tamarkreit/Custom_STIC_RK3588/Datasheets and References/TPS22811_Design_Calculator.xlsm

Sheet: Calculation Sheet
TPS22811 Design Calculation Tool
 | Constants Cells
 | Input/SelectCells
 | Calculation Cells
 | Calculated, but can be over-ridden by user
 | Error Cells, Must be Fixed
Parameter | Description | Value | Units | Tolerance | Recommended Value
VIN (max) | Maximum Operating input voltage (magnitude) | 12.00 | V
OVLO Set Point | Desired Over Voltage Lockout Set Point | 15.00 | V | 3.0%
UVLO Set Point | Desired Undervoltage Threshold (VIN Rising) | 10.80 | V | 3.0%
VUVP | Internal Undervoltage Protection Threshold (VIN Rising) | 2.53 | V | 3.0%
Cout | Load Capacitance | 100.0 | uF | 10.0%
 | Is there downstream load present other than cap at startup? | YES
VONTH (CR) (V) | constant resistance load turn on threshold voltage | 0.0 | V
RLOAD (STARTUP) (Ω) | CR load at startup | 1.5 | Ohm
VONTH (CC) (V) | constant current load turn on threshold voltage | 1.0 | V
ILOAD (STARTUP) (A) | CC load at startup | 0.0 | A
VONTH (CP) (V) | constant power load turn on threshold voltage | 1.0 | V
PLOAD (STARTUP) (W) | CP load at startup | 0.0 | W
Istartup(A) | It is sum of max downstream load current and load cap charge current during startup .It should be <Imax | 8.22 | A
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
