tamarkreit/Custom_STIC_RK3588/v7_Power_Test_PCB/Symbols_and_Footprints/SN74LVC1G14DBVR/SN74LVC1G14DBVR.step

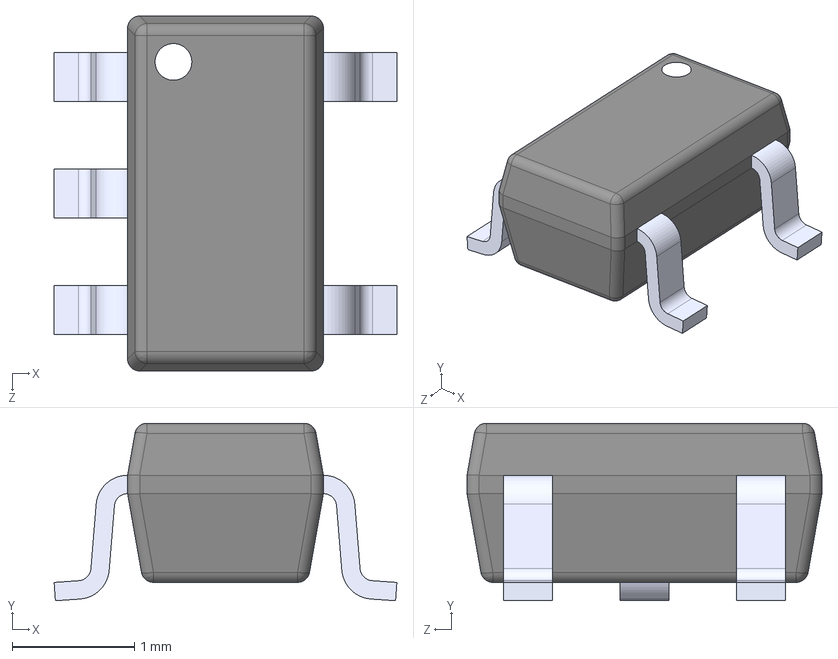
[picture p1: CAD file, 2025-10-29]
v7_Power_Test_PCB/Symbols_and_Footprints/SN74LVC1G14DBVR/SN74LVC1G14DBVR.step
2.80 x 1.45 x 2.90 mm
