tamarkreit/Custom_STIC_RK3588/v7_Power_Test_PCB/Symbols_and_Footprints/Sona_IF573/Sona_IF573_PCB_footprint/Sona IF573_PCB_Footprint.DXF

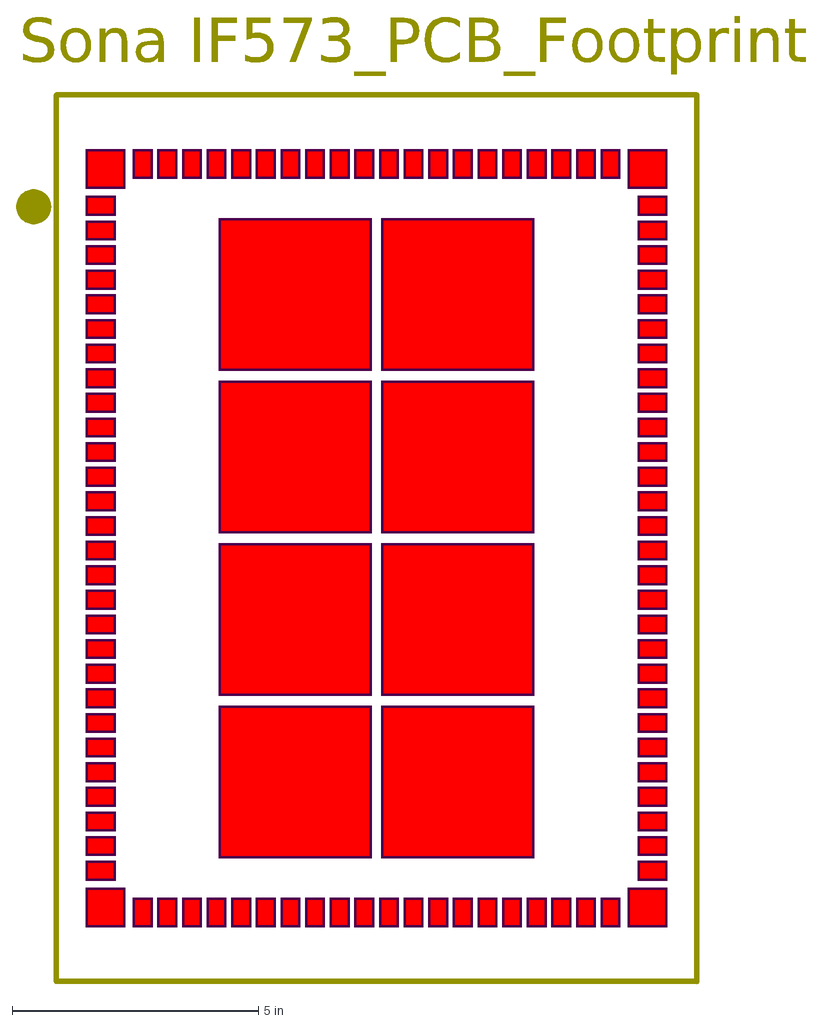
[picture p2: CAD file, 2025-10-29]
v7_Power_Test_PCB/Symbols_and_Footprints/Sona_IF573/Sona_IF573_PCB_footprint/Sona IF573_PCB_Footprint.DXF
Sona IF573_PCB_Footprint
