tamarkreit/Custom_STIC_RK3588/v7_Power_Test_PCB/Symbols_and_Footprints/TUSB320IRWBR/TUSB320IRWBR.step

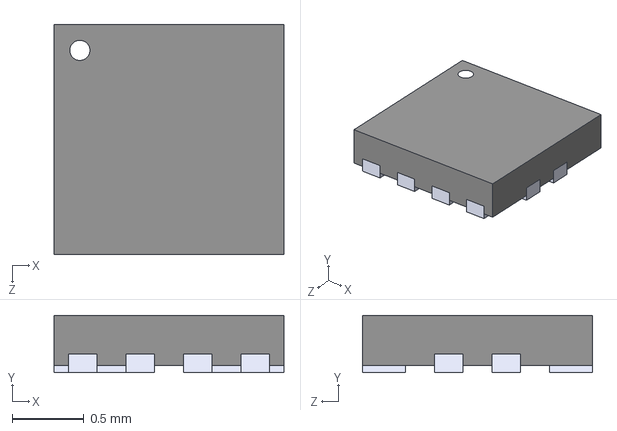
[picture p3: CAD file, 2025-10-16]
v7_Power_Test_PCB/Symbols_and_Footprints/TUSB320IRWBR/TUSB320IRWBR.step
1.60 x 0.4 x 1.60 mm
