tamarkreit/Custom_STIC_RK3588/v7_Power_Test_PCB/Symbols_and_Footprints/USB4056_03_A/USB4056-03-A_REVA2.step

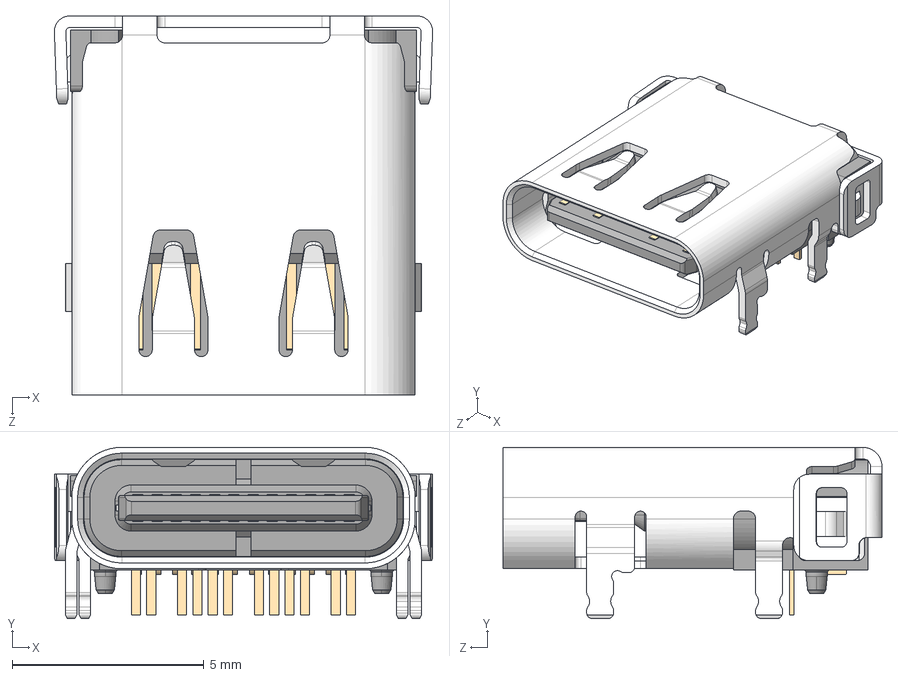
[picture p4: CAD file, 2025-10-16]
v7_Power_Test_PCB/Symbols_and_Footprints/USB4056_03_A/USB4056-03-A_REVA2.step
9.85 x 4.46 x 9.87 mm
