tamarkreit/Custom_STIC_RK3588/v7_Power_Test_PCB/Symbols_and_Footprints/USB4085_GF_A/USB4085-GF-A_REVB.step

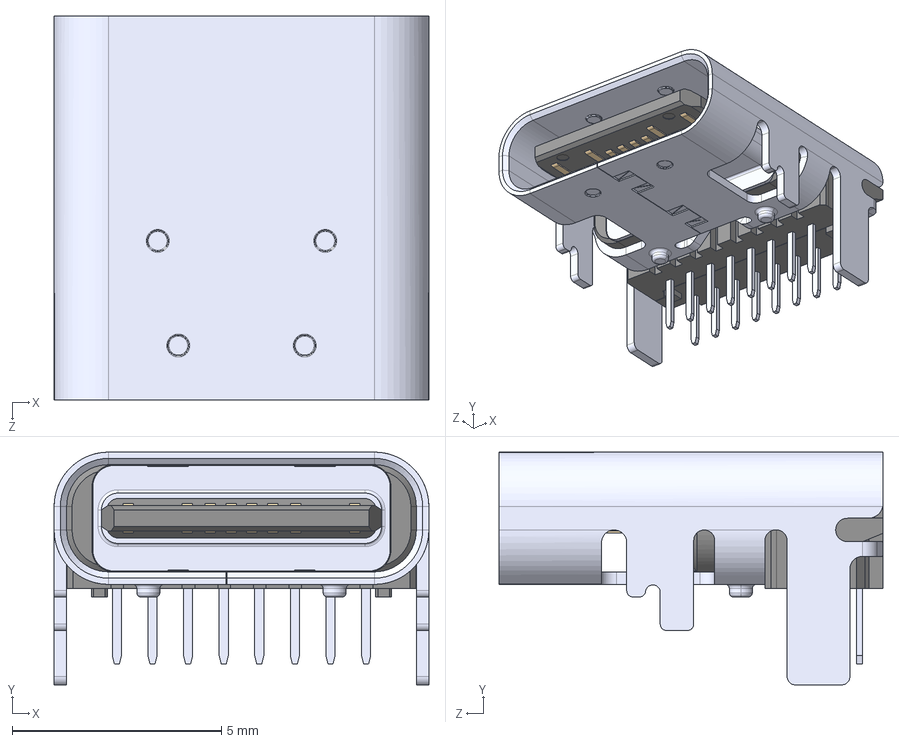
[picture p5: CAD file, 2025-10-16]
v7_Power_Test_PCB/Symbols_and_Footprints/USB4085_GF_A/USB4085-GF-A_REVB.step
8.95 x 5.56 x 9.17 mm
