tamarkreit/Custom_STIC_RK3588/v7_Power_Test_PCB/Symbols_and_Footprints/TPS22811LRPWR/TPS22811LRPWR.step

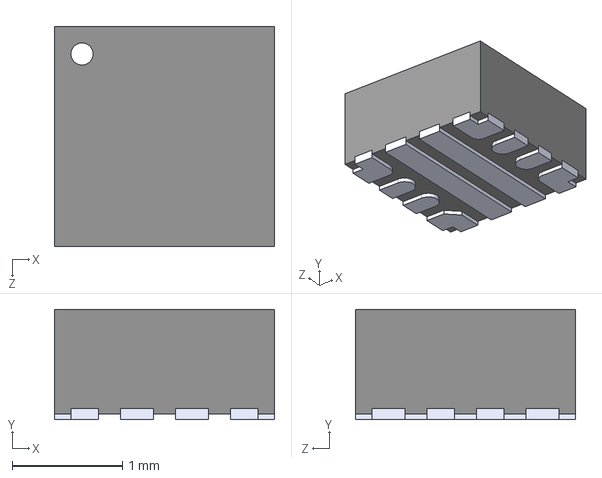
[picture p6: CAD file, 2025-10-16]
v7_Power_Test_PCB/Symbols_and_Footprints/TPS22811LRPWR/TPS22811LRPWR.step
2.00 x 1.00 x 2.00 mm
