tamarkreit/Custom_STIC_RK3588/v7_Power_Test_PCB/Symbols_and_Footprints/TPS61088RHLR/TPS61088RHLR.step

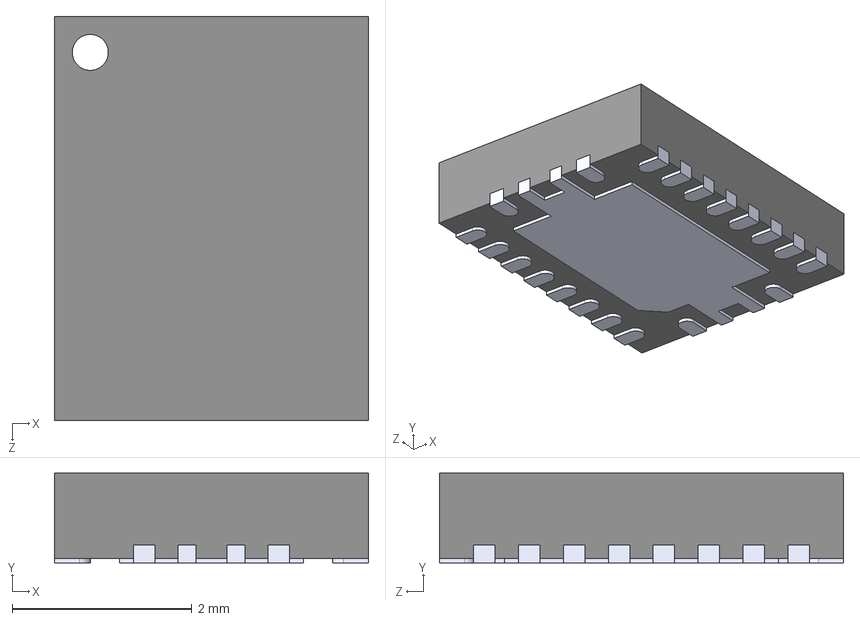
[picture p7: CAD file, 2025-10-16]
v7_Power_Test_PCB/Symbols_and_Footprints/TPS61088RHLR/TPS61088RHLR.step
3.50 x 1.00 x 4.50 mm
