tamarkreit/Custom_STIC_RK3588/v7_Power_Test_PCB/Symbols_and_Footprints/Sona_IF573/Sona_IF573_PCB_footprint/Sona IF573_PCB_Footprint.pdf

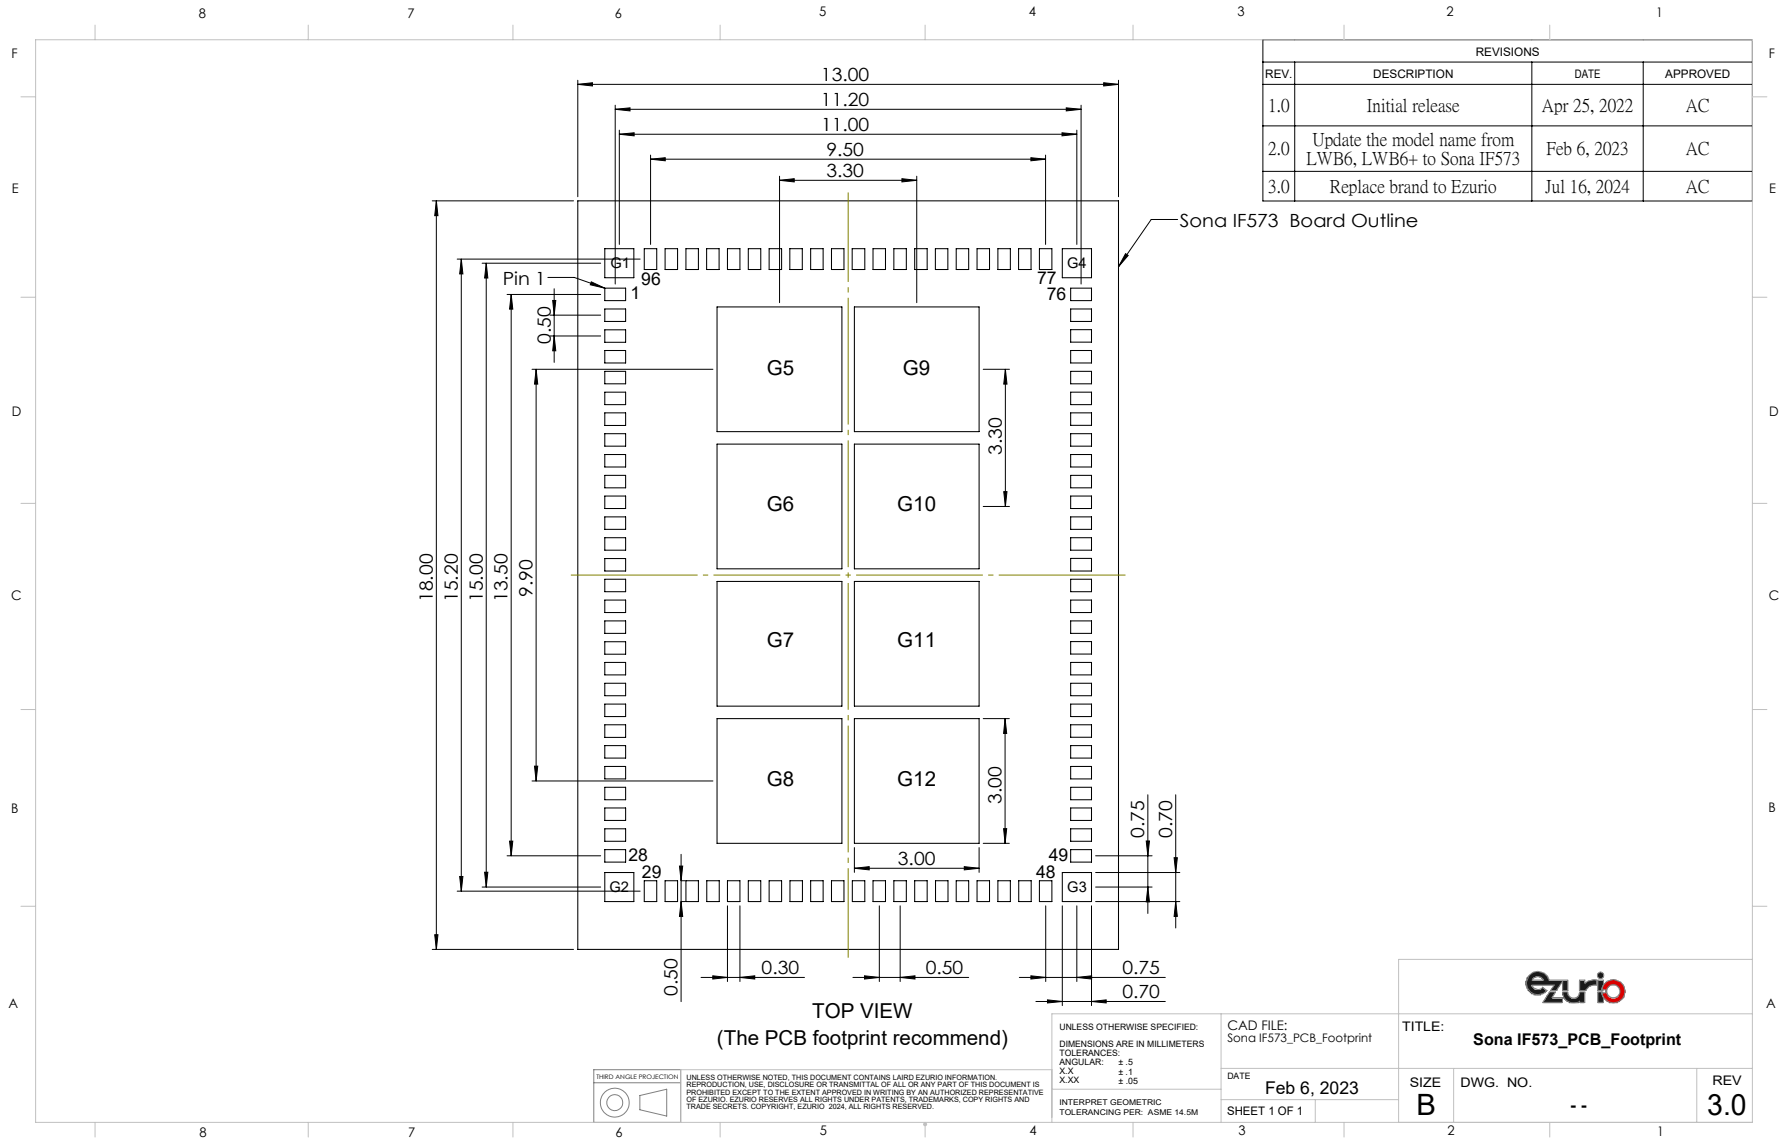
[picture p8: page 1]
Pin 1; TOP VIEW; SHEET 1 OF 1; SIZE DWG. NO.; REV; Sona IF573_PCB_Footprint; CAD FILE: Sona IF573_PCB_Footprint; Feb 6, 2023

REV. | DESCRIPTION | DATE | APPROVED
1.0 | Initial release | Apr 25, 2022 | AC
2.0 | Update the model name from LWB6, LWB6+ to Sona IF573 | Feb 6, 2023 | AC

3.0 | Replace brand to Ezurio | Jul 16, 2024 | AC

Sona IF573 Board Outline

(The PCB footprint recommend)

UNLESS OTHERWISE SPECIFIED:
DIMENSIONS ARE IN MILLIMETERS
TOLERANCES:
ANGULAR:

THIRD ANGLE PROJECTION

± .05 UNLESS OTHERWISE NOTED, THIS DOCUMENT CONTAINS LAIRD EZURIO INFORMATION.
REPRODUCTION, USE, DISCLOSURE OR TRANSMITTAL OF ALL OR ANY PART OF THIS DOCUMENT IS
PROHIBITED EXCEPT TO THE EXTENT APPROVED IN WRITING BY AN AUTHORIZED REPRESENTATIVE
OF EZURIO. EZURIO RESERVES ALL RIGHTS UNDER PATENTS, TRADEMARKS, COPY RIGHTS AND
TRADE SECRETS. COPYRIGHT, EZURIO 2024, ALL RIGHTS RESERVED.

INTERPRET GEOMETRIC
TOLERANCING PER: ASME 14.5M
