tamarkreit/Custom_STIC_RK3588/(list of files, drawings)

Other design files:
v7_Power_Test_PCB/Symbols_and_Footprints/Sona_IF573/Sona_IF573_PCB_footprint/Sona IF573_PCB_Footprint.PcbDoc
v7_Power_Test_PCB/Symbols_and_Footprints/Sona_IF573/Sona_IF573_SCH_Symbol/453-00117_Sona IF573_SCH_Symbol_Altium.SchLib
