tamarkreit/Custom_STIC_RK3588/v7_RK3588_PCB/ESP32.kicad_sch

## KiCad design v7_RK3588_PCB/ESP32.kicad_sch (2025-10-29)

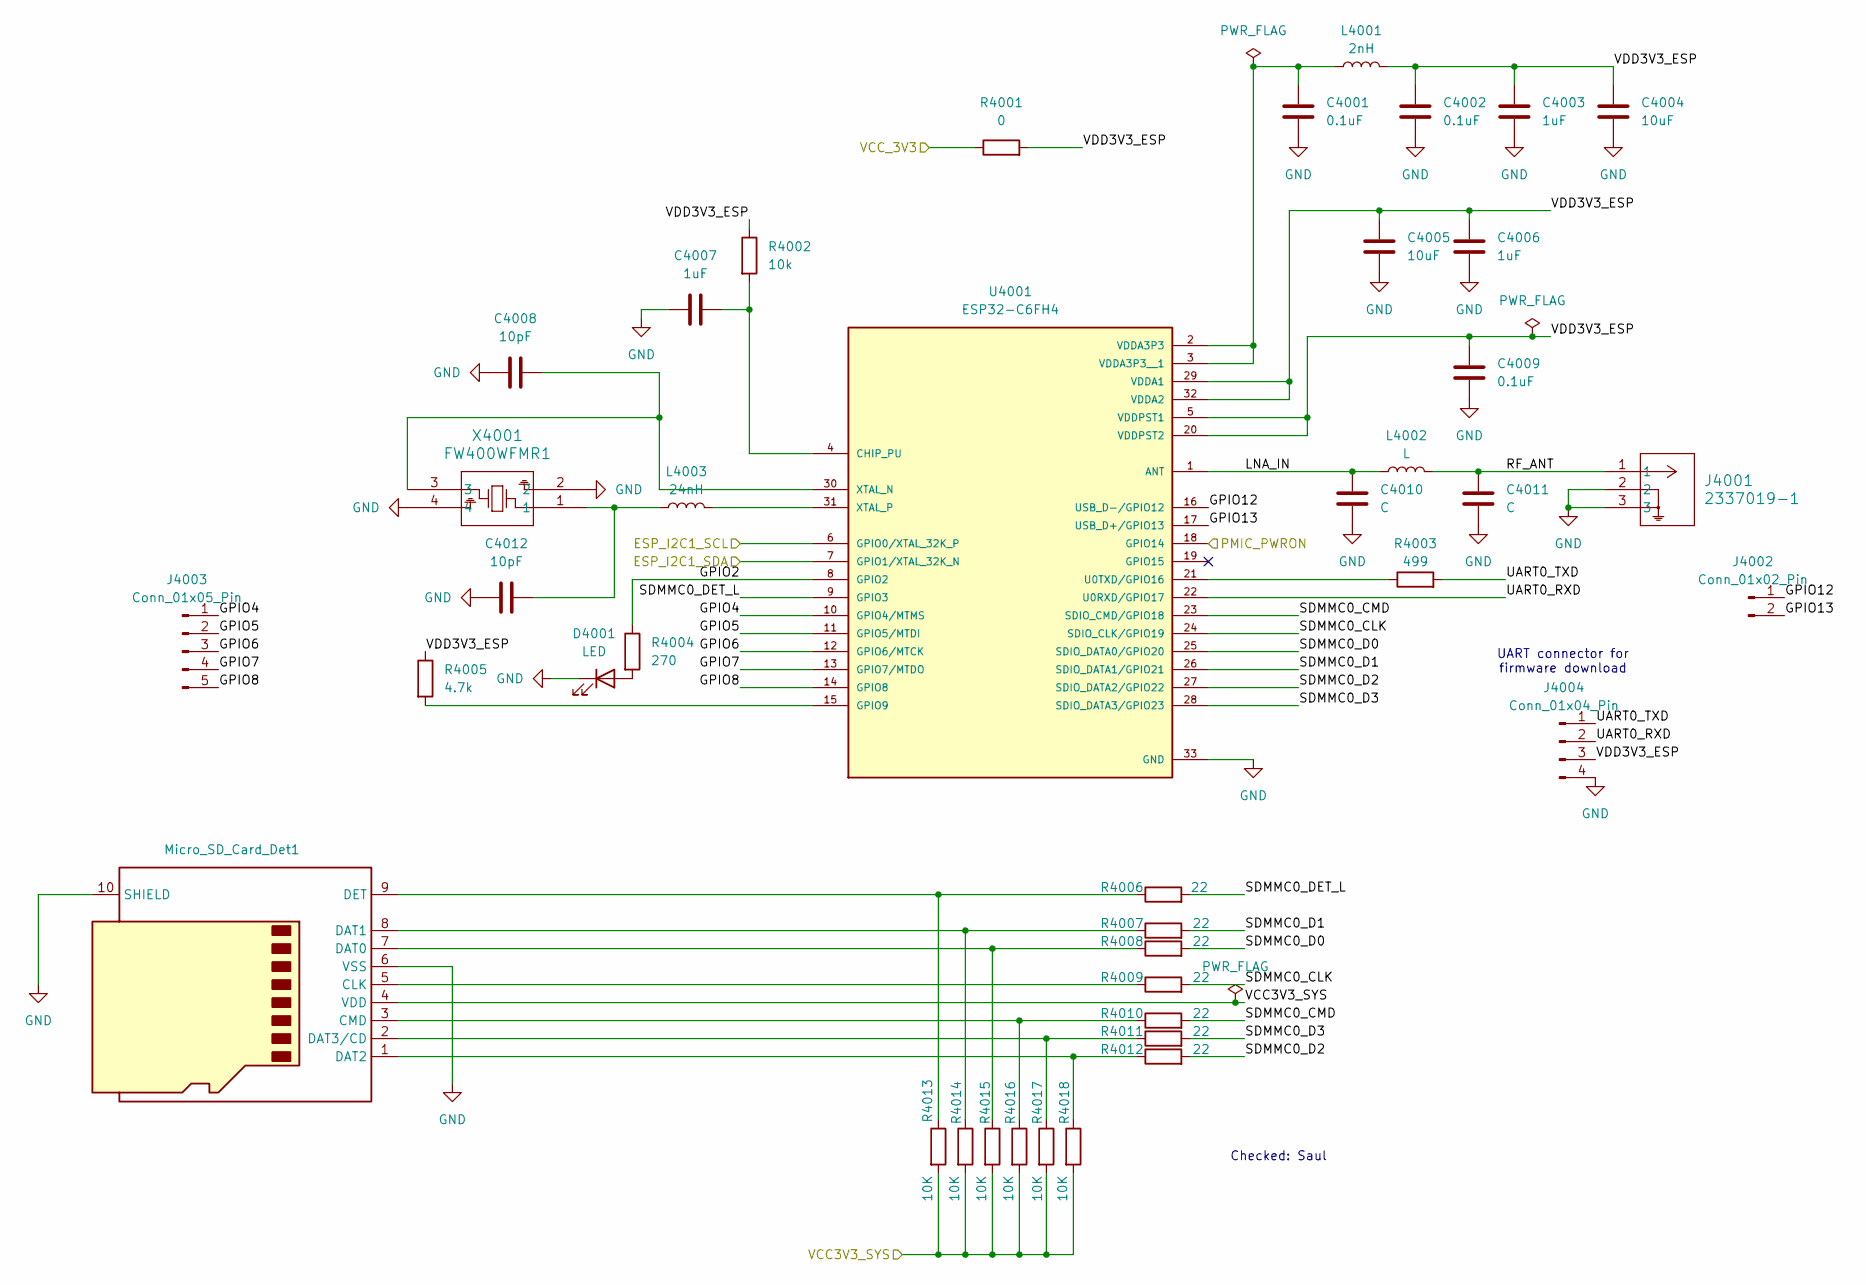
[picture p9: schematic ESP32.kicad_sch]

Parts:
C4001, C4002, C4009: 0.1uF
C4003, C4006, C4007: 1uF
C4004, C4005: 10uF
C4008, C4012: 10pF
C4010, C4011: C
D4001: LED; LED_0805_2012Metric_Pad1.15x1.40mm_HandSolder
J4001: 2337019-1
J4002: Conn_01x02_Pin
J4003: Conn_01x05_Pin
J4004: Conn_01x04_Pin
J4005: Micro_SD_Card_Det1
L4001: 2nH
L4002: L
L4003: 24nH
R4001: 0
R4002: 10k
R4003: 499
R4004: 270
R4005: 4.7k
R4006, R4007, R4008, R4009, R4010, R4011, R4012: 22
R4013, R4014, R4015, R4016, R4017, R4018: 10K
U4001: ESP32-C6FH4; QFN50P500X500X90-33N; PARTREV v0.5
X4001: FW400WFMR1; Crystal_FW400_DIO

Connections:
ESP_I2C1_SCL: U4001.6 (GPIO0/XTAL_32K_P)
ESP_I2C1_SDA: U4001.7 (GPIO1/XTAL_32K_N)
GND: C4001.2, C4002.2, C4003.2, C4004.2, C4005.2, C4006.2, C4007.1, C4008.1, C4009.2, C4010.2, C4011.2, C4012.1, D4001.1 (K), J4001.2, J4001.3, J4004.4, J4005.6 (VSS), J4005.10 (SHIELD), U4001.33 (GND), X4001.2, X4001.4
GPIO2: R4004.1, U4001.8 (GPIO2)
GPIO4: J4003.1, U4001.10 (GPIO4/MTMS)
GPIO5: J4003.2, U4001.11 (GPIO5/MTDI)
GPIO6: J4003.3, U4001.12 (GPIO6/MTCK)
GPIO7: J4003.4, U4001.13 (GPIO7/MTDO)
GPIO8: J4003.5, U4001.14 (GPIO8)
GPIO12: J4002.1, U4001.16 (USB_D-/GPIO12)
GPIO13: J4002.2, U4001.17 (USB_D+/GPIO13)
LNA_IN: C4010.1, L4002.1, U4001.1 (ANT)
unnamed: C4001.1, L4001.1, U4001.2 (VDDA3P3), U4001.3 (VDDA3P3__1)
unnamed: C4007.2, R4002.2, U4001.4 (CHIP_PU)
unnamed: C4008.2, U4001.30 (XTAL_N), X4001.3
unnamed: C4012.2, L4003.1, X4001.1
unnamed: D4001.2 (A), R4004.2
unnamed: J4005.1 (DAT2), R4012.1, R4018.1
unnamed: J4005.2 (DAT3/CD), R4011.1, R4017.1
unnamed: J4005.3 (CMD), R4010.1, R4016.1
unnamed: J4005.5 (CLK), R4009.1
unnamed: J4005.7 (DAT0), R4008.1, R4015.1
unnamed: J4005.8 (DAT1), R4007.1, R4014.1
unnamed: J4005.9 (DET), R4006.1, R4013.1
unnamed: L4003.2, U4001.31 (XTAL_P)
unnamed: R4003.1, U4001.21 (U0TXD/GPIO16)
unnamed: R4005.2, U4001.15 (GPIO9)
PMIC_PWRON: U4001.18 (GPIO14)
RF_ANT: C4011.1, J4001.1, L4002.2
SDMMC0_CLK: R4009.2, U4001.24 (SDIO_CLK/GPIO19)
SDMMC0_CMD: R4010.2, U4001.23 (SDIO_CMD/GPIO18)
SDMMC0_D0: R4008.2, U4001.25 (SDIO_DATA0/GPIO20)
SDMMC0_D1: R4007.2, U4001.26 (SDIO_DATA1/GPIO21)
SDMMC0_D2: R4012.2, U4001.27 (SDIO_DATA2/GPIO22)
SDMMC0_D3: R4011.2, U4001.28 (SDIO_DATA3/GPIO23)
SDMMC0_DET_L: R4006.2, U4001.9 (GPIO3)
UART0_RXD: J4004.2, U4001.22 (U0RXD/GPIO17)
UART0_TXD: J4004.1, R4003.2
VCC3V3_SYS: J4005.4 (VDD), R4013.2, R4014.2, R4015.2, R4016.2, R4017.2, R4018.2
VCC_3V3: R4001.1
VDD3V3_ESP: C4002.1, C4003.1, C4004.1, C4005.1, C4006.1, C4009.1, J4004.3, L4001.2, R4001.2, R4002.1, R4005.1, U4001.5 (VDDPST1), U4001.20 (VDDPST2), U4001.29 (VDDA1), U4001.32 (VDDA2)

Notes on the sheet:
UART connector for firmware download
Checked: Saul
