tamarkreit/Custom_STIC_RK3588/v7_RK3588_PCB/Ethernet.kicad_sch

## KiCad design v7_RK3588_PCB/Ethernet.kicad_sch (2025-10-29)

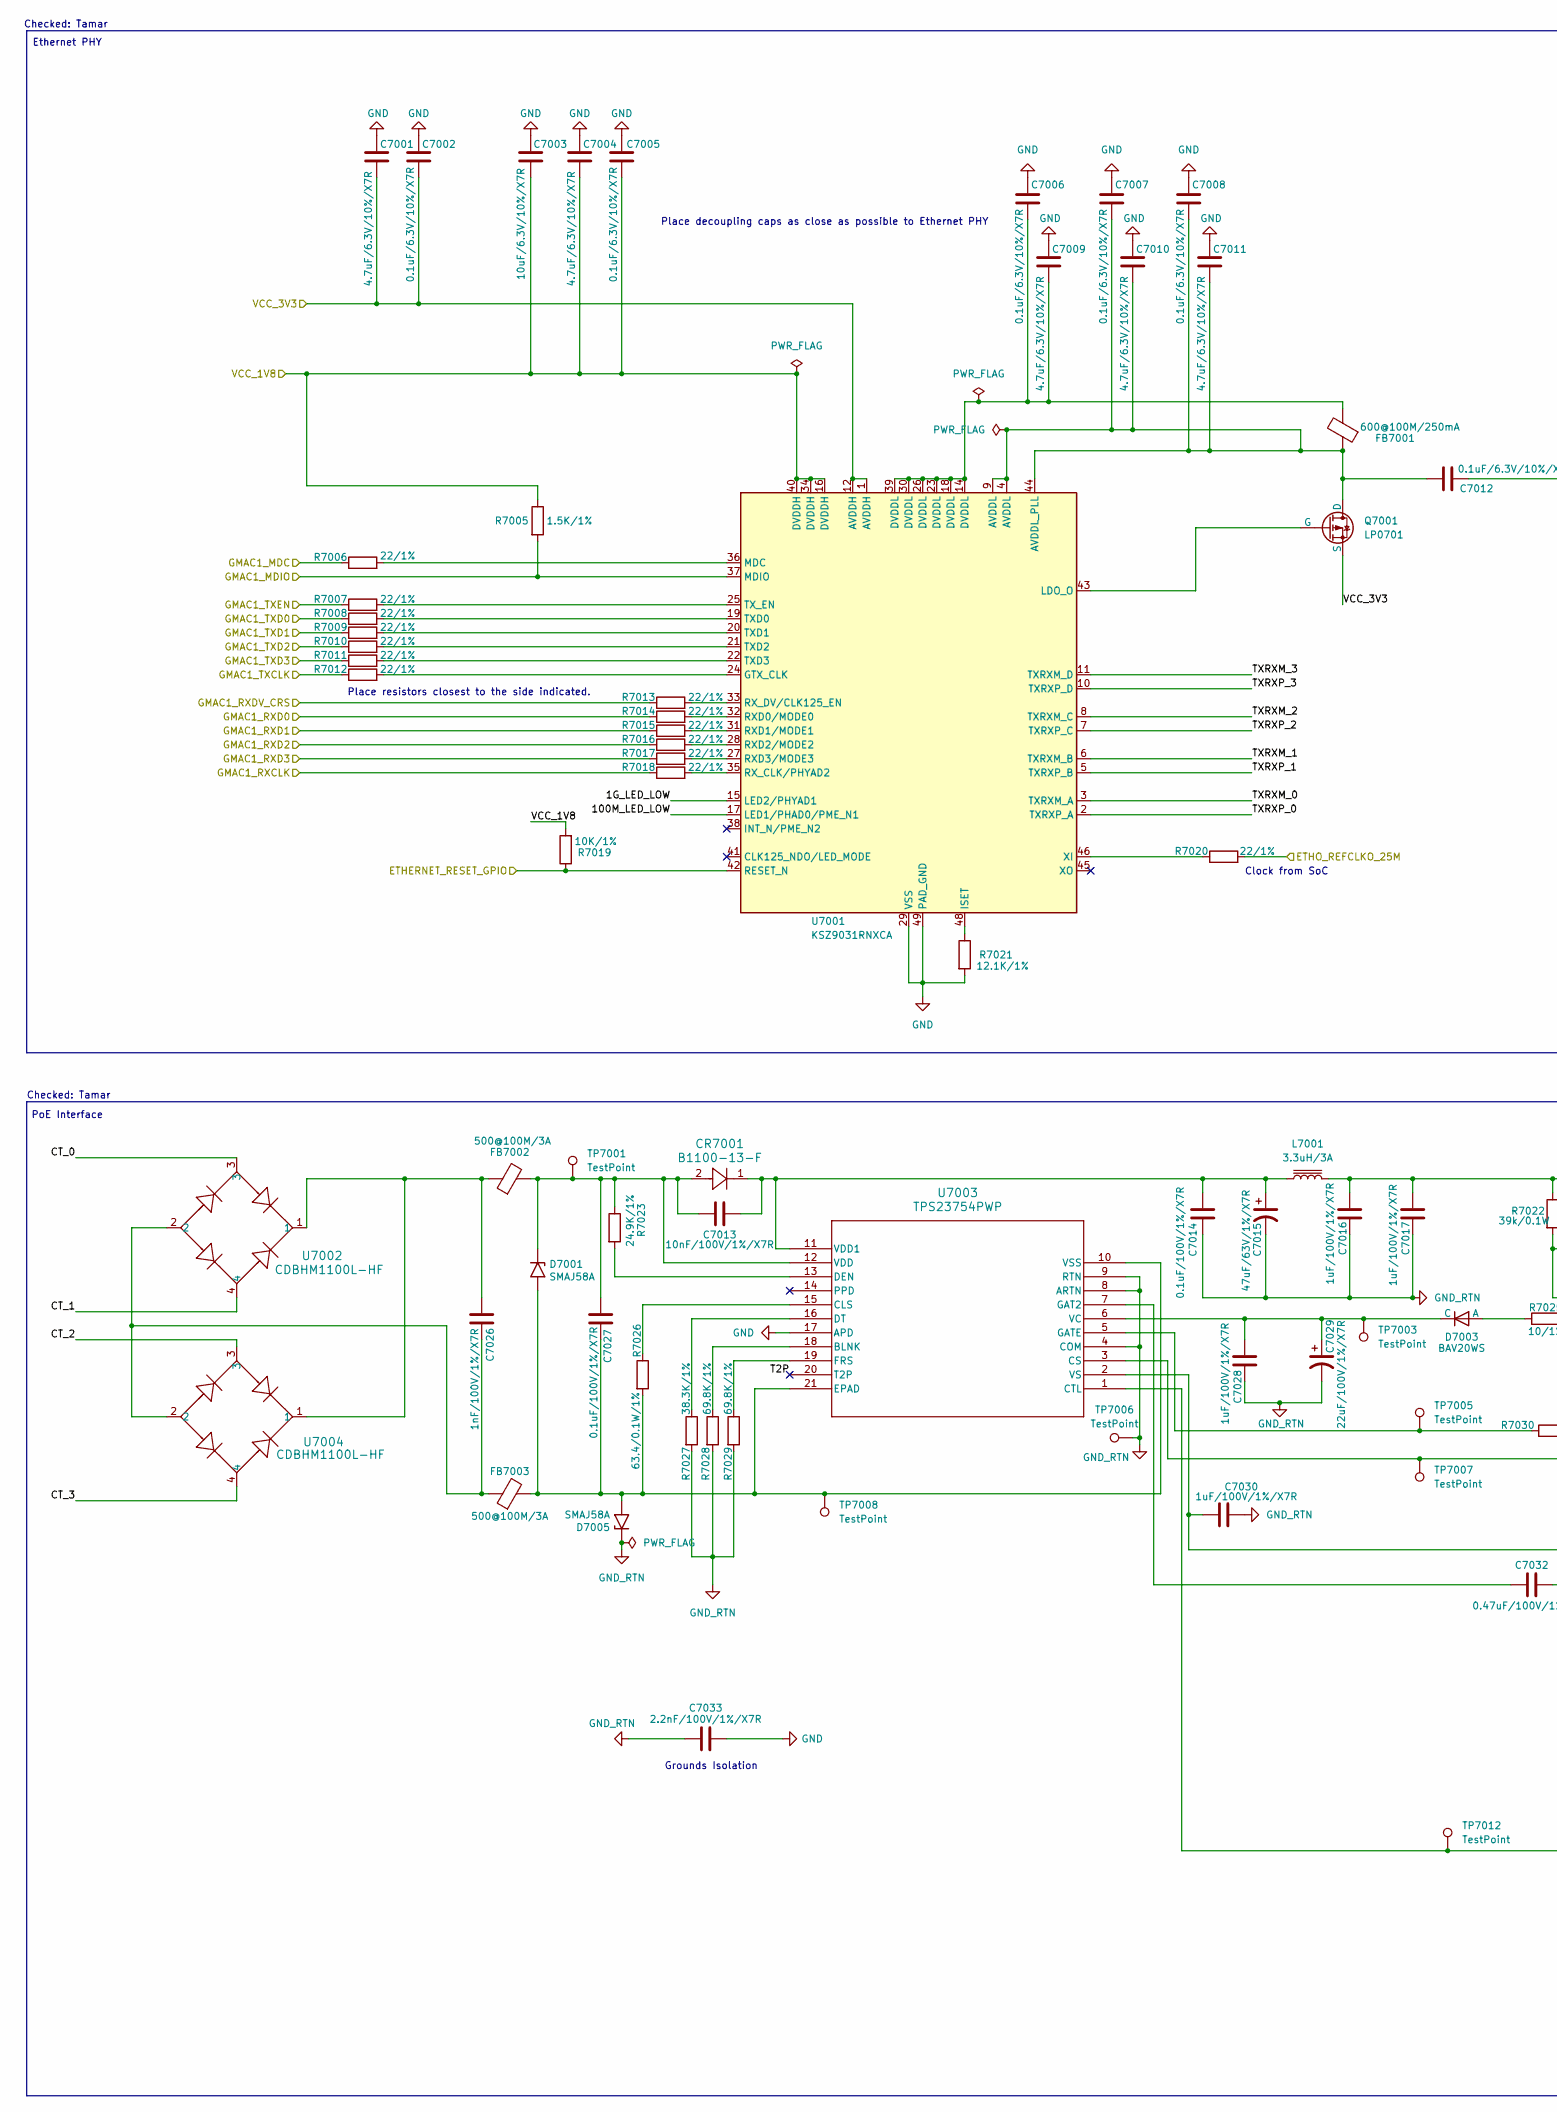
[picture p10: schematic Ethernet.kicad_sch, part in row 1, column 1]

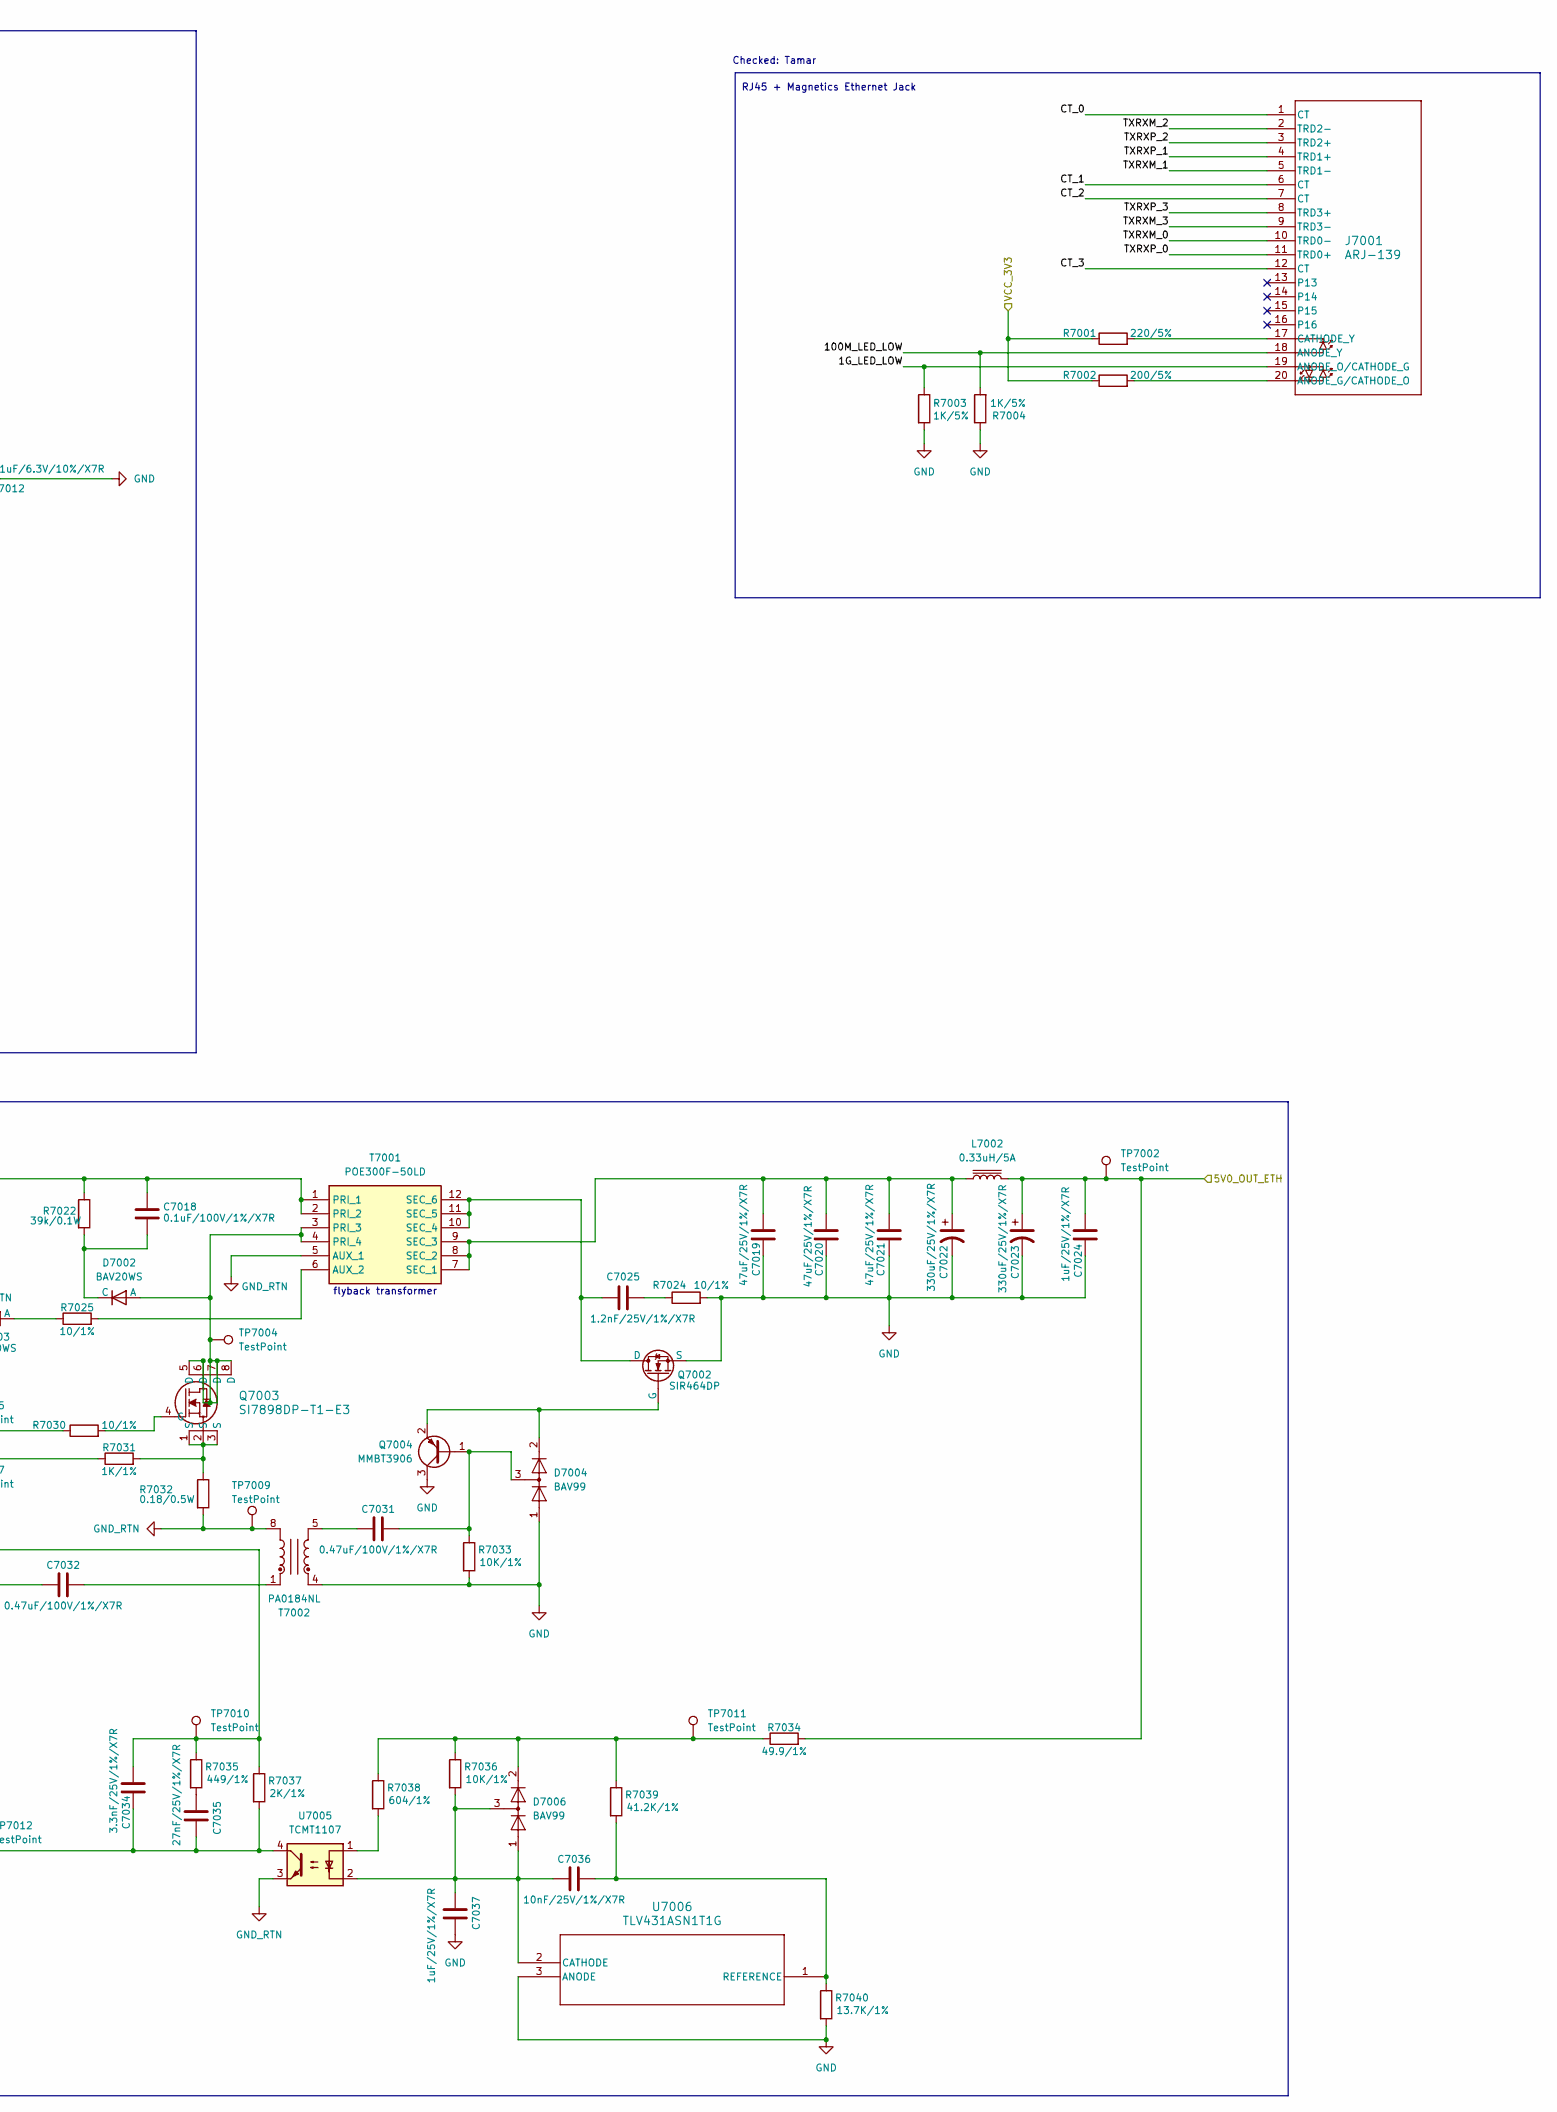
[picture p11: schematic Ethernet.kicad_sch, part in row 1, column 2]

Parts:
C7001, C7004, C7009, C7010, C7011: 4.7uF/6.3V/10%/X7R
C7002, C7005, C7006, C7007, C7008, C7012: 0.1uF/6.3V/10%/X7R
C7003: 10uF/6.3V/10%/X7R
C7013: 10nF/100V/1%/X7R
C7014, C7018, C7027: 0.1uF/100V/1%/X7R
C7015: 47uF/63V/1%/X7R
C7016, C7017, C7028, C7030: 1uF/100V/1%/X7R
C7019, C7020, C7021: 47uF/25V/1%/X7R
C7022, C7023: 330uF/25V/1%/X7R
C7024, C7037: 1uF/25V/1%/X7R
C7025: 1.2nF/25V/1%/X7R
C7026: 1nF/100V/1%/X7R
C7029: 22uF/100V/1%/X7R
C7031, C7032: 0.47uF/100V/1%/X7R
C7033: 2.2nF/100V/1%/X7R
C7034: 3.3nF/25V/1%/X7R
C7035: 27nF/25V/1%/X7R
C7036: 10nF/25V/1%/X7R
CR7001: B1100-13-F
D7001, D7005: SMAJ58A; D_SMA
D7002, D7003: BAV20WS
D7004, D7006: BAV99; SOT-23
FB7001: 600@100M/250mA
FB7002, FB7003: 500@100M/3A
J7001: ARJ-139
L7001: 3.3uH/3A
L7002: 0.33uH/5A
Q7001: LP0701
Q7002: SIR464DP; Vishay_PowerPAK_1212-8_Single
Q7003: SI7898DP-T1-E3
Q7004: MMBT3906; SOT-23
R7001: 220/5%
R7002: 200/5%
R7003, R7004: 1K/5%
R7005: 1.5K/1%
R7006, R7007, R7008, R7009, R7010, R7011, R7012, R7013, R7014, R7015, R7016, R7017, R7018, R7020: 22/1%
R7019, R7033, R7036: 10K/1%
R7021: 12.1K/1%
R7022: 39k/0.1W
R7023: 24.9K/1%
R7024, R7025, R7030: 10/1%
R7026: 63.4/0.1W/1%
R7027: 38.3K/1%
R7028, R7029: 69.8K/1%
R7031: 1K/1%
R7032: 0.18/0.5W
R7034: 49.9/1%
R7035: 449/1%
R7037: 2K/1%
R7038: 604/1%
R7039: 41.2K/1%
R7040: 13.7K/1%
T7001: POE300F-50LD; Manufacturer_Part_Number POE300F-50LD; Mouser Part Number 994-POE300F-50LD
T7002: PA0184NL; Pulse_PA2007NL
TP7001, TP7002, TP7003, TP7004, TP7005, TP7006, TP7007, TP7008, TP7009, TP7010, TP7011, TP7012: TestPoint
U7001: KSZ9031RNXCA; QFN-48-1EP_7x7mm_P0.5mm_EP5.15x5.15mm
U7002, U7004: CDBHM1100L-HF
U7003: TPS23754PWP
U7005: TCMT1107; SOP-4_4.4x2.6mm_P1.27mm
U7006: TLV431ASN1T1G

Connections:
1G_LED_LOW: J7001.19 (ANODE_O/CATHODE_G), R7003.1, U7001.15 (LED2/PHYAD1)
5V0_OUT_ETH: C7023.1, C7024.1, L7002.2, R7034.2, TP7002.1
100M_LED_LOW: J7001.18 (ANODE_Y), R7004.2, U7001.17 (LED1/PHAD0/PME_N1)
CT_0: J7001.1 (CT), U7002.3
CT_1: J7001.6 (CT), U7002.4
CT_2: J7001.7 (CT), U7004.3
CT_3: J7001.12 (CT), U7004.4
ETHERNET_RESET_GPIO: R7019.1, U7001.42 (RESET_N)
ETHO_REFCLKO_25M: R7020.2
GMAC1_MDC: R7006.1
GMAC1_MDIO: R7005.2, U7001.37 (MDIO)
GMAC1_RXCLK: R7018.1
GMAC1_RXD0: R7014.1
GMAC1_RXD1: R7015.1
GMAC1_RXD2: R7016.1
GMAC1_RXD3: R7017.1
GMAC1_RXDV_CRS: R7013.1
GMAC1_TXCLK: R7012.1
GMAC1_TXD0: R7008.1
GMAC1_TXD1: R7009.1
GMAC1_TXD2: R7010.1
GMAC1_TXD3: R7011.1
GMAC1_TXEN: R7007.1
GND: C7001.1, C7002.1, C7003.1, C7004.1, C7005.1, C7006.1, C7007.1, C7008.1, C7009.1, C7010.1, C7011.1, C7012.2, C7019.2, C7020.2, C7021.2, C7022.2, C7023.2, C7024.2, C7033.2, C7037.2, D7004.1 (K), Q7002.3 (S), Q7004.3 (C), R7003.2, R7004.1, R7021.2, R7024.2, R7033.2, R7040.2, T7002.4, U7001.29 (VSS), U7001.49 (PAD_GND), U7003.17 (APD), U7006.3 (ANODE)
GND_RTN: C7014.2, C7015.2, C7016.2, C7017.2, C7028.2, C7029.2, C7030.2, C7033.1, D7005.1 (A1), R7027.2, R7028.2, R7029.2, R7032.2, T7001.5 (AUX_1), T7002.8, TP7006.1, TP7009.1, U7003.4 (COM), U7003.8 (ARTN), U7003.9 (RTN), U7005.3
unnamed: C7006.2, C7009.2, FB7001.2, U7001.14 (DVDDL), U7001.18 (DVDDL), U7001.23 (DVDDL), U7001.26 (DVDDL), U7001.30 (DVDDL), U7001.39 (DVDDL)
unnamed: C7007.2, C7008.2, C7010.2, C7011.2, C7012.1, FB7001.1, Q7001.1 (D), U7001.4 (AVDDL), U7001.9 (AVDDL), U7001.44 (AVDDL_PLL)
unnamed: C7013.1, C7027.1, CR7001.2, D7001.1 (A1), FB7002.2, R7023.1, TP7001.1, U7003.12 (VDD)
unnamed: C7013.2, C7014.1, C7015.1, CR7001.1, L7001.1, U7003.11 (VDD1)
unnamed: C7016.1, C7017.1, C7018.1, L7001.2, R7022.1, T7001.1 (PRI_1), T7001.2 (PRI_2)
unnamed: C7018.2, D7002.2 (C), R7022.2
unnamed: C7019.1, C7020.1, C7021.1, C7022.1, L7002.1, T7001.7 (SEC_1), T7001.8 (SEC_2), T7001.9 (SEC_3)
unnamed: C7025.1, Q7002.1 (D), T7001.10 (SEC_4), T7001.11 (SEC_5), T7001.12 (SEC_6)
unnamed: C7025.2, R7024.1
unnamed: C7026.1, FB7002.1, U7002.1, U7004.1
unnamed: C7026.2, FB7003.1, U7002.2, U7004.2
unnamed: C7027.2, D7001.2 (A2), D7005.2 (A2), FB7003.2, R7026.2, TP7008.1, U7003.10 (VSS), U7003.21 (EPAD)
unnamed: C7028.1, C7029.1, D7003.2 (C), TP7003.1, U7003.6 (VC)
unnamed: C7030.1, C7034.1, R7035.1, R7037.1, TP7010.1, U7003.2 (VS)
unnamed: C7031.1, T7002.5
unnamed: C7031.2, D7004.3 (K), Q7004.1 (B), R7033.1
unnamed: C7032.1, U7003.7 (GAT2)
unnamed: C7032.2, T7002.1
unnamed: C7034.2, C7035.2, R7037.2, TP7012.1, U7003.1 (CTL), U7005.4
unnamed: C7035.1, R7035.2
unnamed: C7036.1, C7037.1, D7006.1 (K), D7006.3 (K), R7036.2, U7005.2, U7006.2 (CATHODE)
unnamed: C7036.2, R7039.2, R7040.1, U7006.1 (REFERENCE)
unnamed: D7002.1 (A), Q7003.5 (D), Q7003.6 (D), Q7003.7 (D), Q7003.8 (D), T7001.3 (PRI_3), T7001.4 (PRI_4), TP7004.1
unnamed: D7003.1 (A), R7025.1
unnamed: D7004.2 (A), Q7002.2 (G), Q7004.2 (E)
unnamed: D7006.2 (A), R7034.1, R7036.1, R7038.1, R7039.1, TP7011.1
unnamed: J7001.17 (CATHODE_Y), R7001.2
unnamed: J7001.20 (ANODE_G/CATHODE_O), R7002.2
unnamed: Q7001.2 (G), U7001.43 (LDO_O)
unnamed: Q7003.1 (S), Q7003.2 (S), Q7003.3 (S), R7031.2, R7032.1
unnamed: Q7003.4 (G), R7030.2
unnamed: R7006.2, U7001.36 (MDC)
unnamed: R7007.2, U7001.25 (TX_EN)
unnamed: R7008.2, U7001.19 (TXD0)
unnamed: R7009.2, U7001.20 (TXD1)
unnamed: R7010.2, U7001.21 (TXD2)
unnamed: R7011.2, U7001.22 (TXD3)
unnamed: R7012.2, U7001.24 (GTX_CLK)
unnamed: R7013.2, U7001.33 (RX_DV/CLK125_EN)
unnamed: R7014.2, U7001.32 (RXD0/MODE0)
unnamed: R7015.2, U7001.31 (RXD1/MODE1)
unnamed: R7016.2, U7001.28 (RXD2/MODE2)
unnamed: R7017.2, U7001.27 (RXD3/MODE3)
unnamed: R7018.2, U7001.35 (RX_CLK/PHYAD2)
unnamed: R7020.1, U7001.46 (XI)
unnamed: R7021.1, U7001.48 (ISET)
unnamed: R7023.2, U7003.13 (DEN)
unnamed: R7025.2, T7001.6 (AUX_2)
unnamed: R7026.1, U7003.15 (CLS)
unnamed: R7027.1, U7003.16 (DT)
unnamed: R7028.1, U7003.18 (BLNK)
unnamed: R7029.1, U7003.19 (FRS)
unnamed: R7030.1, TP7005.1, U7003.5 (GATE)
unnamed: R7031.1, TP7007.1, U7003.3 (CS)
unnamed: R7038.2, U7005.1
T2P: U7003.20 (T2P)
TXRXM_0: J7001.10 (TRD0-), U7001.3 (TXRXM_A)
TXRXM_1: J7001.5 (TRD1-), U7001.6 (TXRXM_B)
TXRXM_2: J7001.2 (TRD2-), U7001.8 (TXRXM_C)
TXRXM_3: J7001.9 (TRD3-), U7001.11 (TXRXM_D)
TXRXP_0: J7001.11 (TRD0+), U7001.2 (TXRXP_A)
TXRXP_1: J7001.4 (TRD1+), U7001.5 (TXRXP_B)
TXRXP_2: J7001.3 (TRD2+), U7001.7 (TXRXP_C)
TXRXP_3: J7001.8 (TRD3+), U7001.10 (TXRXP_D)
VCC_1V8: C7003.2, C7004.2, C7005.2, R7005.1, R7019.2, U7001.16 (DVDDH), U7001.34 (DVDDH), U7001.40 (DVDDH)
VCC_3V3: C7001.2, C7002.2, Q7001.3 (S), R7001.1, R7002.1, U7001.1 (AVDDH), U7001.12 (AVDDH)

Notes on the sheet:
Place resistors closest to the side indicated.
Checked: Tamar
Clock from SoC
Ethernet PHY
RJ45 + Magnetics Ethernet Jack
Grounds Isolation
Place decoupling caps as close as possible to Ethernet PHY
PoE Interface
flyback transformer
