tamarkreit/Custom_STIC_RK3588/v7_RK3588_PCB/GPS.kicad_sch

## KiCad design v7_RK3588_PCB/GPS.kicad_sch (2025-10-29)

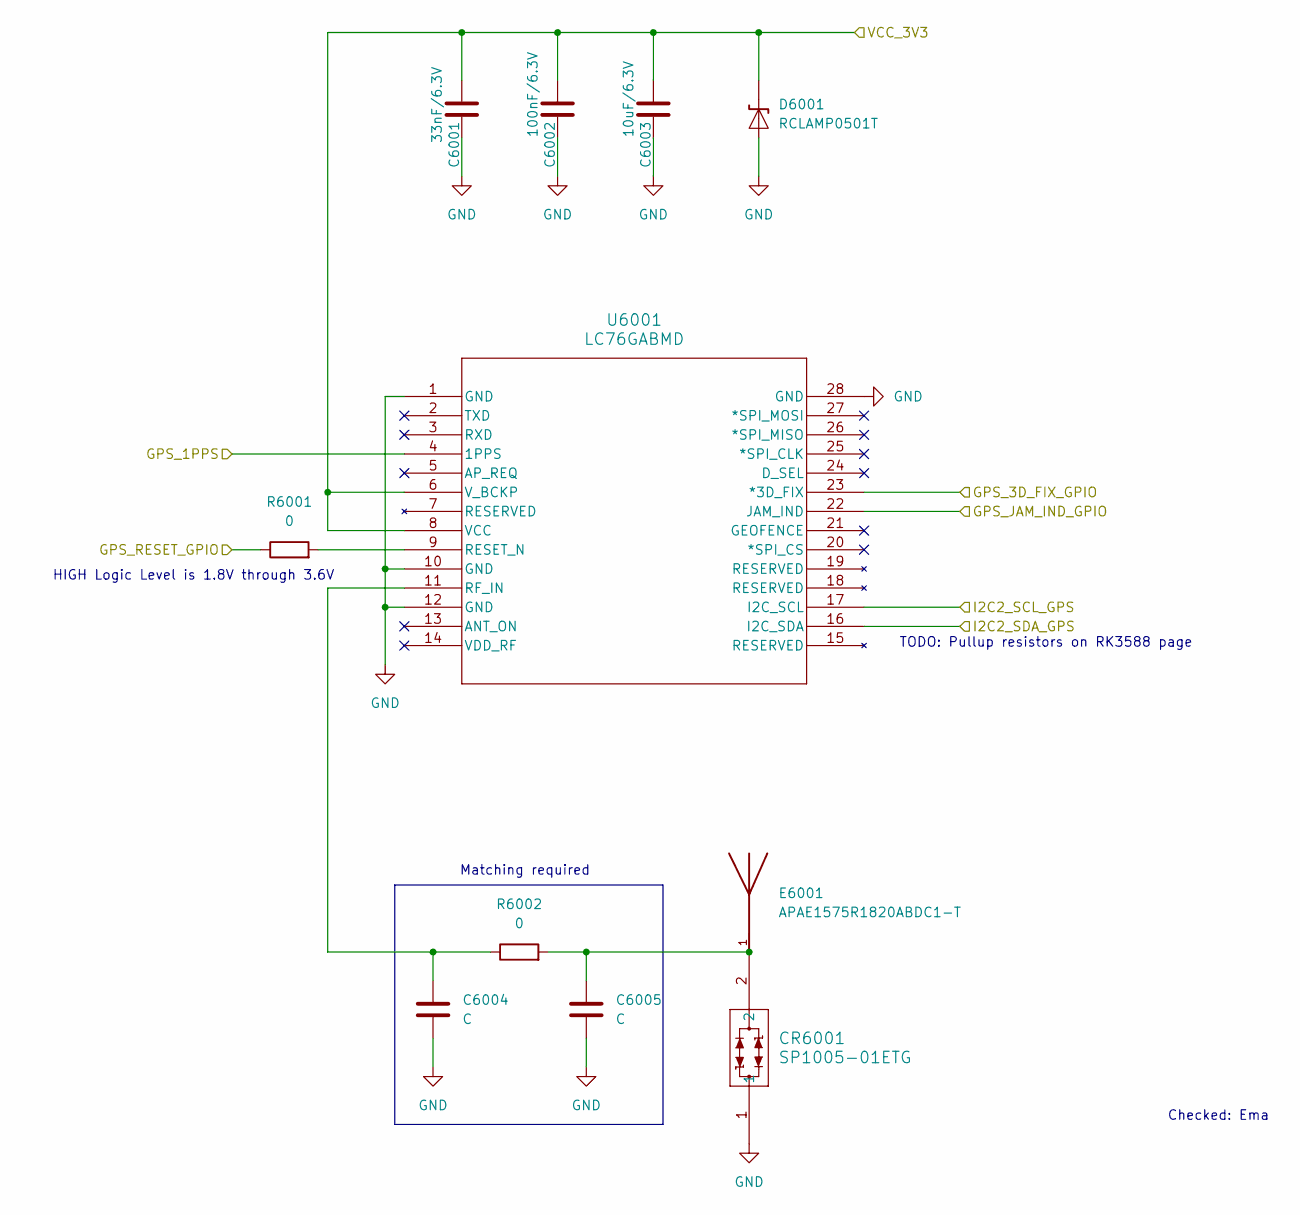
[picture p12: schematic GPS.kicad_sch]

Parts:
C6001: 33nF/6.3V
C6002: 100nF/6.3V
C6003: 10uF/6.3V
C6004, C6005: C
CR6001: SP1005-01ETG
D6001: RCLAMP0501T
E6001: APAE1575R1820ABDC1-T; XDCR_APAE1575R1820ABDC1-T
R6001, R6002: 0
U6001: LC76GABMD

Connections:
GND: C6001.2, C6002.2, C6003.2, C6004.2, C6005.2, CR6001.1, D6001.1 (A1), U6001.1 (GND), U6001.10 (GND), U6001.12 (GND), U6001.28 (GND)
GPS_1PPS: U6001.4 (1PPS)
GPS_3D_FIX_GPIO: U6001.23 (*3D_FIX)
GPS_JAM_IND_GPIO: U6001.22 (JAM_IND)
GPS_RESET_GPIO: R6001.1
I2C2_SCL_GPS: U6001.17 (I2C_SCL)
I2C2_SDA_GPS: U6001.16 (I2C_SDA)
unnamed: C6004.1, R6002.1, U6001.11 (RF_IN)
unnamed: C6005.1, CR6001.2, E6001.1, R6002.2
unnamed: R6001.2, U6001.9 (RESET_N)
VCC_3V3: C6001.1, C6002.1, C6003.1, D6001.2 (A2), U6001.6 (V_BCKP), U6001.8 (VCC)

Notes on the sheet:
TODO: Pullup resistors on RK3588 page
Checked: Ema
HIGH Logic Level is 1.8V through 3.6V
Matching required
