tamarkreit/Custom_STIC_RK3588/v7_RK3588_PCB/Power_Management.kicad_sch

## KiCad design v7_RK3588_PCB/Power_Management.kicad_sch (2025-10-29)

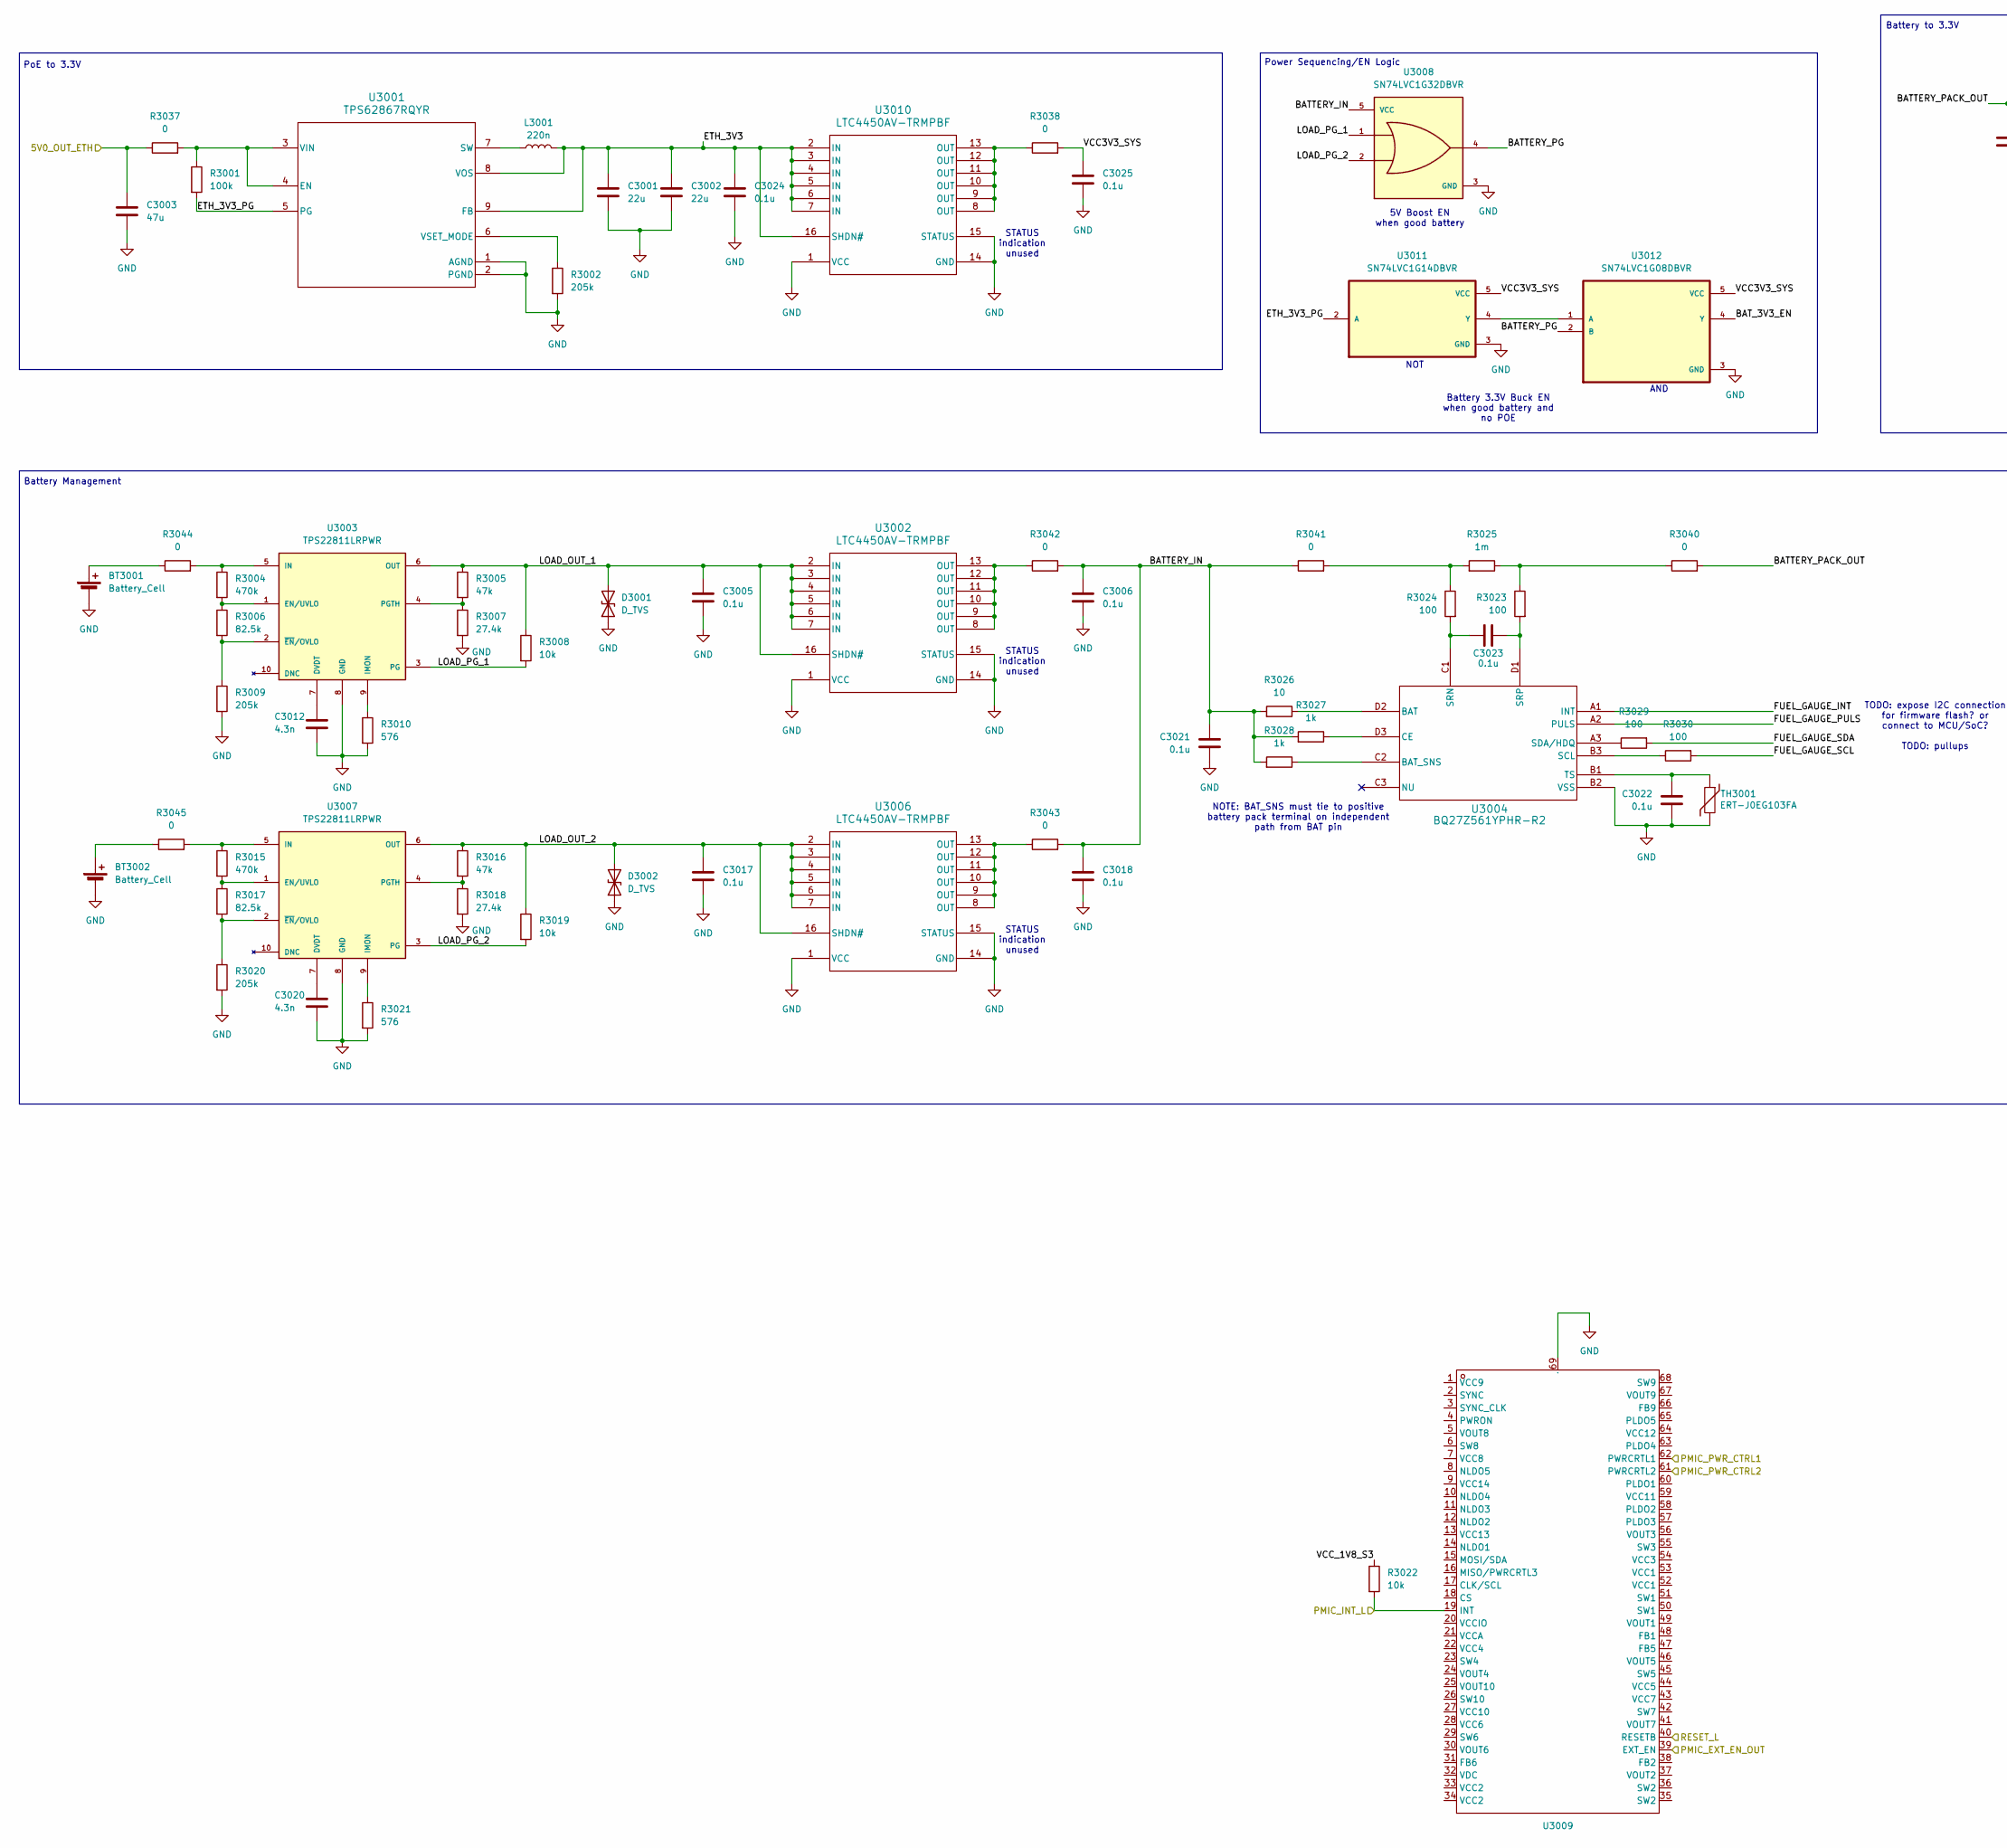
[picture p13: schematic Power_Management.kicad_sch, part in row 1, column 1]

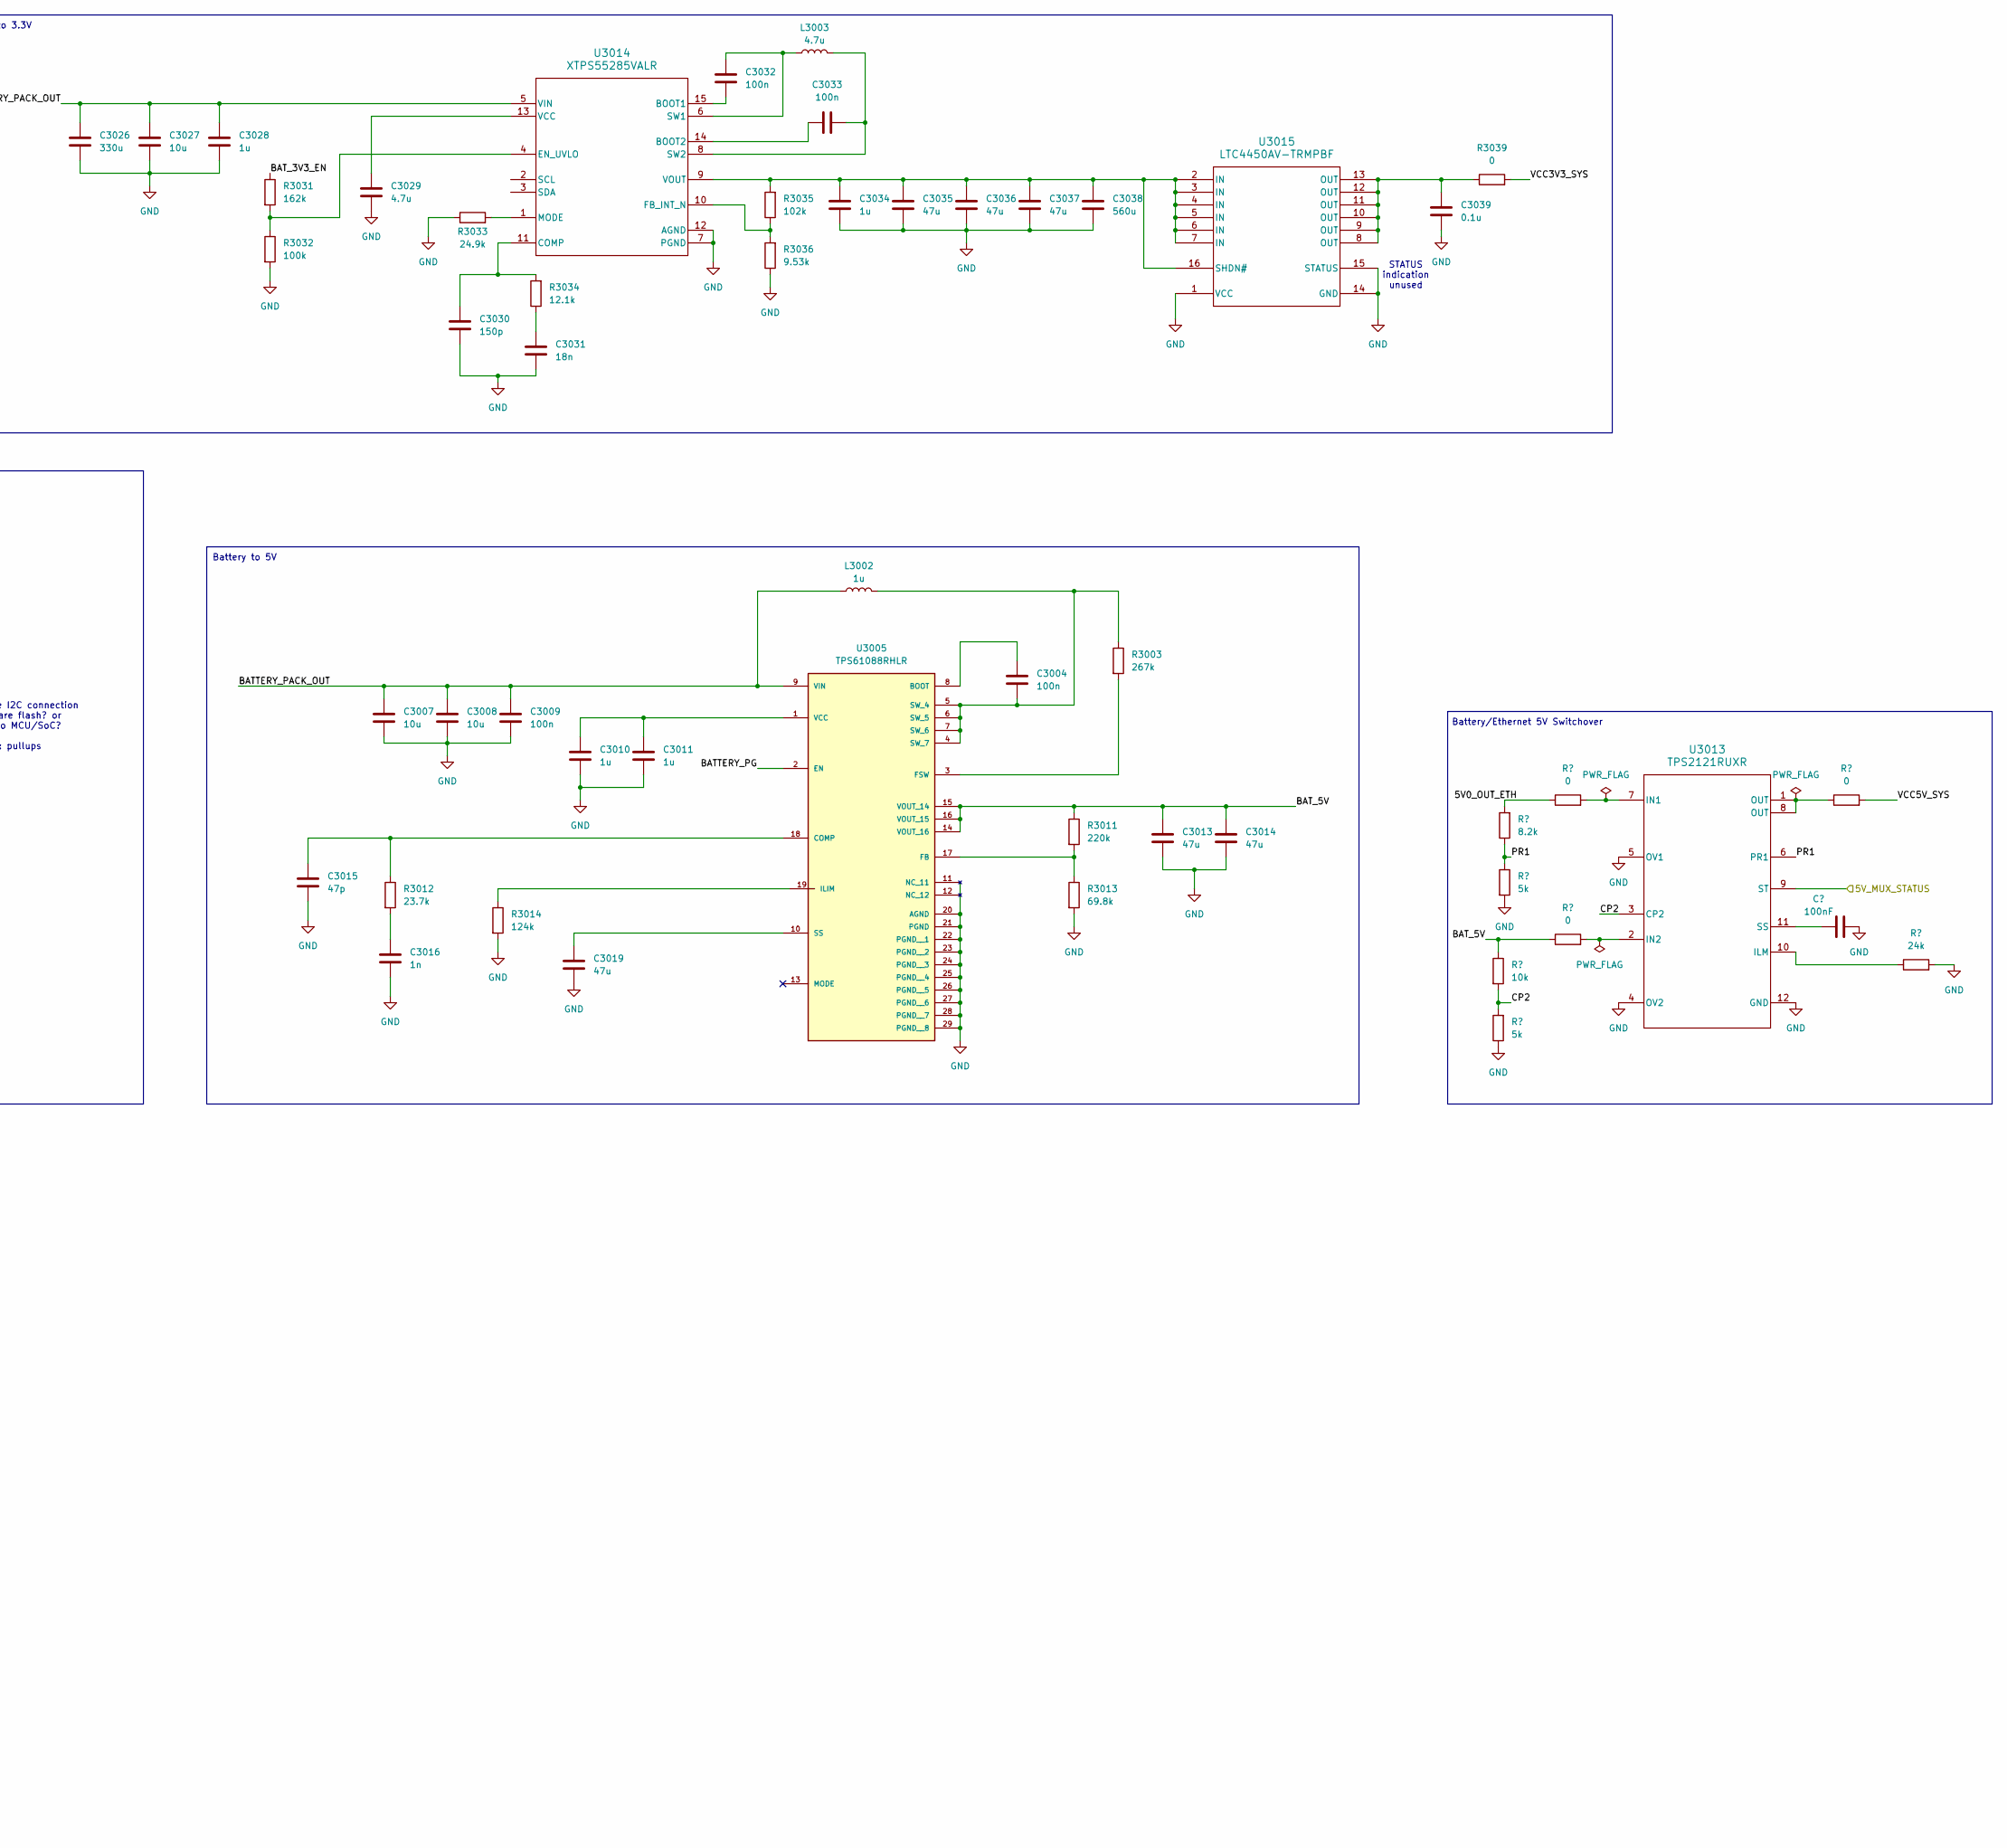
[picture p14: schematic Power_Management.kicad_sch, part in row 1, column 2]

Parts:
BT3001, BT3002: Battery_Cell
C3001, C3002: 22u
C3003, C3013, C3014, C3019, C3035, C3036, C3037: 47u
C3004, C3009, C3032, C3033: 100n
C3005, C3006, C3017, C3018, C3021, C3022, C3023, C3024, C3025, C3039: 0.1u
C3007, C3008, C3027: 10u
C3010, C3011, C3028, C3034: 1u
C3012, C3020: 4.3n
C3015: 47p
C3016: 1n
C3026: 330u
C3029: 4.7u
C3030: 150p
C3031: 18n
C3038: 560u
D3001, D3002: D_TVS; DFN1006-2L_TWS
L3001: 220n
L3002: 1u
L3003: 4.7u
R3001, R3032: 100k
R3002, R3009, R3020: 205k
R3003: 267k
R3004, R3015: 470k
R3005, R3016: 47k
R3006, R3017: 82.5k
R3007, R3018: 27.4k
R3008, R3019, R3022: 10k
R3010, R3021: 576
R3011: 220k
R3012: 23.7k
R3013: 69.8k
R3014: 124k
R3023, R3024, R3029, R3030: 100
R3025: 1m
R3026: 10
R3027, R3028: 1k
R3031: 162k
R3033: 24.9k
R3034: 12.1k
R3035: 102k
R3036: 9.53k
R3037, R3038, R3039, R3040, R3041, R3042, R3043, R3044, R3045: 0
TH3001: ERT-J0EG103FA
U3001: TPS62867RQYR; RQY0009A-MFG
U3002, U3006, U3010, U3015: LTC4450AV-TRMPBF; 05-08-1683_ADI
U3003, U3007: TPS22811LRPWR; IC_TPS22811LRPWR; PARTREV A
U3004: BQ27Z561YPHR-R2; DSBGA_YPHR-R2_TEX
U3005: TPS61088RHLR; IC_TPS61088RHLR; PARTREV 4219071/A 05/2017
U3008: SN74LVC1G32DBVR; SOT95P280X145-5N; PARTREV V
U3009: QFN-68_L7.0-W7.0-P0.35-BL-EP5.5; Manufacturer Part RK806-1; LCSC Part Name RK806-1
U3011: SN74LVC1G14DBVR; SOT95P280X145-5N
U3012: SN74LVC1G08DBVR; SOT95P280X145-5N
U3013: TPS2121RUXR; RUX0012A
U3014: XTPS55285VALR; VAL0015A

Connections:
5V0_OUT_ETH: C3003.1, R3037.1
5V_MUX_STATUS: U3013.9 (ST)
BATTERY_IN: C3006.1, C3018.1, C3021.1, R3026.2, R3027.2, R3028.2, R3041.1, R3042.2, R3043.2, U3008.5 (VCC)
BATTERY_PACK_OUT: C3007.1, C3008.1, C3009.1, C3026.1, C3027.1, C3028.1, L3002.1, R3040.2, U3005.9 (VIN), U3014.5 (VIN)
BATTERY_PG: U3005.2 (EN), U3008.4, U3012.2 (B)
BAT_3V3_EN: R3031.1, U3012.4 (Y)
BAT_5V: C3013.1, C3014.1, R3011.1, U3005.14 (VOUT_16), U3005.15 (VOUT_14), U3005.16 (VOUT_15)
CP2: U3013.3 (CP2)
ETH_3V3: C3001.1, C3002.1, C3024.1, L3001.2, U3001.8 (VOS), U3001.9 (FB), U3010.2 (IN), U3010.3 (IN), U3010.4 (IN), U3010.5 (IN), U3010.6 (IN), U3010.7 (IN), U3010.16 (SHDN#)
ETH_3V3_PG: R3001.2, U3001.5 (PG), U3011.2 (A)
FUEL_GAUGE_INT: U3004.A1 (INT)
FUEL_GAUGE_PULS: U3004.A2 (PULS)
FUEL_GAUGE_SCL: R3030.2
FUEL_GAUGE_SDA: R3029.2
GND: BT3001.2 (-), BT3002.2 (-), C3001.2, C3002.2, C3003.2, C3005.2, C3006.2, C3007.2, C3008.2, C3009.2, C3010.2, C3011.2, C3012.2, C3013.2, C3014.2, C3015.2, C3016.2, C3017.2, C3018.2, C3019.2, C3020.2, C3021.2, C3022.2, C3024.2, C3025.2, C3026.2, C3027.2, C3028.2, C3029.2, C3030.2, C3031.2, C3034.2, C3035.2, C3036.2, C3037.2, C3038.2, C3039.2, D3001.1 (A1), D3002.1 (A1), R3002.2, R3007.2, R3009.2, R3010.2, R3013.2, R3014.2, R3018.2, R3020.2, R3021.2, R3032.2, R3033.1, R3036.1, TH3001.2, U3001.1 (AGND), U3001.2 (PGND), U3002.1 (VCC), U3002.14 (GND), U3002.15 (STATUS), U3003.8 (GND), U3004.B2 (VSS), U3005.11 (NC_11), U3005.20 (AGND), U3005.21 (PGND), U3005.22 (PGND__1), U3005.23 (PGND__2), U3005.24 (PGND__3), U3005.25 (PGND__4), U3005.26 (PGND__5), U3005.27 (PGND__6), U3005.28 (PGND__7), U3005.29 (PGND__8), U3006.1 (VCC), U3006.14 (GND), U3006.15 (STATUS), U3007.8 (GND), U3008.3 (GND), U3009.69 (PAD), U3010.1 (VCC), U3010.14 (GND), U3010.15 (STATUS), U3011.3 (GND), U3012.3 (GND), U3014.7 (PGND), U3014.12 (AGND), U3015.1 (VCC), U3015.14 (GND), U3015.15 (STATUS)
LOAD_OUT_1: C3005.1, D3001.2 (A2), R3005.1, R3008.1, U3002.2 (IN), U3002.3 (IN), U3002.4 (IN), U3002.5 (IN), U3002.6 (IN), U3002.7 (IN), U3002.16 (SHDN#), U3003.6 (OUT)
LOAD_OUT_2: C3017.1, D3002.2 (A2), R3016.1, R3019.1, U3006.2 (IN), U3006.3 (IN), U3006.4 (IN), U3006.5 (IN), U3006.6 (IN), U3006.7 (IN), U3006.16 (SHDN#), U3007.6 (OUT)
LOAD_PG_1: R3008.2, U3003.3 (PG), U3008.1
LOAD_PG_2: R3019.2, U3007.3 (PG), U3008.2
unnamed: BT3001.1 (+), R3044.1
unnamed: BT3002.1 (+), R3045.1
unnamed: C3004.1, U3005.8 (BOOT)
unnamed: C3004.2, L3002.2, R3003.1, U3005.4 (SW_7), U3005.5 (SW_4), U3005.6 (SW_5), U3005.7 (SW_6)
unnamed: C3010.1, C3011.1, U3005.1 (VCC)
unnamed: C3012.1, U3003.7 (DVDT)
unnamed: C3015.1, R3012.1, U3005.18 (COMP)
unnamed: C3016.1, R3012.2
unnamed: C3019.1, U3005.10 (SS)
unnamed: C3020.1, U3007.7 (DVDT)
unnamed: C3022.1, TH3001.1, U3004.B1 (TS)
unnamed: C3023.1, R3023.2, U3004.D1 (SRP)
unnamed: C3023.2, R3024.2, U3004.C1 (SRN)
unnamed: C3029.1, U3014.13 (VCC)
unnamed: C3030.1, R3034.2, U3014.11 (COMP)
unnamed: C3031.1, R3034.1
unnamed: C3032.1, L3003.1, U3014.6 (SW1)
unnamed: C3032.2, U3014.15 (BOOT1)
unnamed: C3033.1, L3003.2, U3014.8 (SW2)
unnamed: C3033.2, U3014.14 (BOOT2)
unnamed: C3034.1, C3035.1, C3036.1, C3037.1, C3038.1, R3035.2, U3014.9 (VOUT), U3015.2 (IN), U3015.3 (IN), U3015.4 (IN), U3015.5 (IN), U3015.6 (IN), U3015.7 (IN), U3015.16 (SHDN#)
unnamed: C3039.1, R3039.1, U3015.8 (OUT), U3015.9 (OUT), U3015.10 (OUT), U3015.11 (OUT), U3015.12 (OUT), U3015.13 (OUT)
unnamed: L3001.1, U3001.7 (SW)
unnamed: R3001.1, R3037.2, U3001.3 (VIN), U3001.4 (EN)
unnamed: R3002.1, U3001.6 (VSET_MODE)
unnamed: R3003.2, U3005.3 (FSW)
unnamed: R3004.1, R3044.2, U3003.5 (IN)
unnamed: R3004.2, R3006.1, U3003.1 (EN/UVLO)
unnamed: R3005.2, R3007.1, U3003.4 (PGTH)
unnamed: R3006.2, R3009.1, U3003.2 (~EN/OVLO)
unnamed: R3010.1, U3003.9 (IMON)
unnamed: R3011.2, R3013.1, U3005.17 (FB)
unnamed: R3014.1, U3005.19 (ILIM)
unnamed: R3015.1, R3045.2, U3007.5 (IN)
unnamed: R3015.2, R3017.1, U3007.1 (EN/UVLO)
unnamed: R3016.2, R3018.1, U3007.4 (PGTH)
unnamed: R3017.2, R3020.1, U3007.2 (~EN/OVLO)
unnamed: R3021.1, U3007.9 (IMON)
unnamed: R3023.1, R3025.1, R3040.1
unnamed: R3024.1, R3025.2, R3041.2
unnamed: R3026.1, U3004.D2 (BAT)
unnamed: R3027.1, U3004.D3 (CE)
unnamed: R3028.1, U3004.C2 (BAT_SNS)
unnamed: R3029.1, U3004.A3 (SDA/HDQ)
unnamed: R3030.1, U3004.B3 (SCL)
unnamed: R3031.2, R3032.1, U3014.4 (EN_UVLO)
unnamed: R3033.2, U3014.1 (MODE)
unnamed: R3035.1, R3036.2, U3014.10 (FB_INT_N)
unnamed: R3038.1, U3010.8 (OUT), U3010.9 (OUT), U3010.10 (OUT), U3010.11 (OUT), U3010.12 (OUT), U3010.13 (OUT)
unnamed: R3042.1, U3002.8 (OUT), U3002.9 (OUT), U3002.10 (OUT), U3002.11 (OUT), U3002.12 (OUT), U3002.13 (OUT)
unnamed: R3043.1, U3006.8 (OUT), U3006.9 (OUT), U3006.10 (OUT), U3006.11 (OUT), U3006.12 (OUT), U3006.13 (OUT)
unnamed: U3011.4 (Y), U3012.1 (A)
unnamed: U3013.1 (OUT), U3013.8 (OUT)
PMIC_EXT_EN_OUT: U3009.39 (EXT_EN)
PMIC_INT_L: R3022.2, U3009.19 (INT)
PMIC_PWR_CTRL1: U3009.62 (PWRCRTL1)
PMIC_PWR_CTRL2: U3009.61 (PWRCRTL2)
PR1: U3013.6 (PR1)
RESET_L: U3009.40 (RESETB)
VCC3V3_SYS: C3025.1, R3038.2, R3039.2, U3011.5 (VCC), U3012.5 (VCC)
VCC_1V8_S3: R3022.1

Notes on the sheet:
STATUS indication unused
Battery to 5V
Battery to 3.3V
AND
PoE to 3.3V
5V Boost EN when good battery
Battery Management
TODO: expose I2C connection for firmware flash? or connect to MCU/SoC? TODO: pullups
Battery/Ethernet 5V Switchover
Power Sequencing/EN Logic
NOT
NOTE: BAT_SNS must tie to positive battery pack terminal on independent path from BAT pin
Battery 3.3V Buck EN when good battery and no POE
