tamarkreit/Custom_STIC_RK3588/v7_RK3588_PCB/RK3588.kicad_sch

## KiCad design v7_RK3588_PCB/RK3588.kicad_sch (2025-10-28)

Schematic: RK3588.kicad_sch

Parts:
C2001, C2007: 100nF/10V
C2002: 10n/25V
C2003, C2004: 9pF/50V
C2005: 1nF/50V
C2006: 10uF/10V
C2008, C2011: 100nF/6.3V
C2009: 1n/50V
C2010: 100n/16V
D2001, D2002: PJE5UFN10A-AU_R1_000A1; Manufacturer_Part_Number PJE5UFN10A-AU_R1_000A1; Mouser Part Number 241-PJE5UFN10AAUR100
D2003, D2004: D_TVS; DFN1006-2L_TWS
J2001: Micro_SD_Card_Det1
J2002: Conn_01x04_Pin
R2001, R2009, R2010, R2011, R2012, R2013, R2014: 22
R2002, R2003, R2015: 10k
R2004: 0
R2005: 510k
R2006: 100k
R2007: 20k
R2008, R2016, R2017: 100
U2001: FCBGA-1088_L23.0-W23.0-P0.65-TL_RK3588; Manufacturer Part RK3588; LCSC Part Name RK3588
X2001: TSX-3225 24.0000MF20G-AC0; CRYSTAL_TSX-3225_TSX-3225 24.0000MF20G-AC0_EPS

Connections:
VCCIO_SD_S0: C2011.1, U2001.Y7 (VCCIO2)
VCC_1V8_S0: C2008.1, U2001.AA7 (VCCIO2_1V8)
GND: C2001.2, C2002.2, C2003.2, C2004.2, C2005.2, C2006.2, C2007.2, C2008.2, C2009.2, C2010.1, C2011.2, D2001.3 (GND_1), D2001.8 (GND_2), D2002.3 (GND_1), D2002.8 (GND_2), D2003.1 (A1), D2004.1 (A1), J2001.6 (VSS), J2001.10 (SHIELD), J2002.4, R2007.2, X2001.2, X2001.4
NPOR_u: C2001.1, R2004.1, U2001.M31 (NPOR_u)
unnamed: C2004.1, R2001.1, X2001.1
unnamed: C2005.1, R2006.2, R2007.1, U2001.AM16 (SARADC_IN0_BOOT)
unnamed: C2009.1, R2015.2, U2001.AL16 (SARADC_IN1)
unnamed: D2001.1 (I/O_1), J2001.1 (DAT2), R2014.1
unnamed: D2001.2 (I/O_2), J2001.2 (DAT3/CD), R2013.1
unnamed: D2001.4 (I/O_3), J2001.3 (CMD), R2012.1
unnamed: D2002.1 (I/O_1), J2001.9 (DET), R2008.1
unnamed: D2002.2 (I/O_2), J2001.8 (DAT1), R2009.1
unnamed: D2002.4 (I/O_3), J2001.7 (DAT0), R2010.1
unnamed: D2002.5 (I/O_4), J2001.5 (CLK), R2011.1
unnamed: D2003.2 (A2), J2002.3, R2017.2
unnamed: D2004.2 (A2), J2002.2, R2016.2
PMIC_INT_L: R2002.2
RESET_L: C2002.1, R2003.2
SDMMC0_CLK: R2011.2, U2001.AE1 (SDMMC_CLK/PDM1_CLK0_M0/TEST_CLKOUT_M0/M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)
SDMMC0_CMD: R2012.2, U2001.AE2 (SDMMC_CMD/PDM1_CLK1_M0/MCU_JTAG_TCK_M0/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)
SDMMC0_D0: R2010.2, U2001.AD2 (SDMMC_D0/PDM1_SDI3_M0/JTAG_TCK_M1/I2C3_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)
SDMMC0_D1: R2009.2, U2001.AD1 (SDMMC_D1/PDM1_SDI2_M0/JTAG_TMS_M1/I2C3_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)
SDMMC0_D2: R2014.2, U2001.AF2 (SDMMC_D2/PDM1_SDI1_M0/JTAG_TCK_M0/I2C8_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)
SDMMC0_D3: R2013.2, U2001.AF1 (SDMMC_D3/PDM1_SDI0_M0/JTAG_TMS_M0/I2C8_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)
SDMMC0_DET_L: R2008.2, U2001.P31 (SDMMC_DET/GPIO0_A4_u)
TSADC_SHUT_H: R2004.2
UART2_RX_M0: R2017.1, U2001.R29 (I2S1_SCLK_TX_M1/JTAG_TMS_M2/I2C1_SDA_M0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)
UART2_TX_M0: R2016.1, U2001.P30 (I2S1_SDI0_M1/GPU_AVS/UART0_TX_M0/I2C4_S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)
VCC3V3_SD: C2006.1, C2007.1, J2001.4 (VDD)
VCCA_1V8_S0: R2006.1, R2015.1
VCC_1V8_S3: R2002.1, R2003.1
VCC_3V3_S3: C2010.2, J2002.1
XIN24M: C2003.1, R2005.2, U2001.R34 (XIN_24M), X2001.3
XOUT24M: R2001.2, R2005.1, U2001.T34 (XOUT_24M)

Notes on the sheet:
place close to chip
2.1.6 UART Debug
TODO: cap calc design guide pg 21
2.1.4 System Boot Sequence via SDMMC0 Card
2.1.2 Reset/watchdog/TSADC Circuit
config. for SD card boot
place close to uSD
TODO: check if all resistors
2.1.1 Clock Circuit
