tamarkreit/Custom_STIC_RK3588/(commit log)

2025-10-15 create KiCad project and schematic hierarchy
    [ESP32.kicad_sch, Encoder.kicad_sch, Ethernet.kicad_sch, GPS.kicad_sch, Power_Management.kicad_sch, RK3588.kicad_sch, WiFi.kicad_sch, v7_RK3588_PCB.kicad_pcb]
2025-10-16 add Datasheets and References folder and content
    [Rockchip_Support_List_DDR_Ver2.64.xlsx, TPS22811_Design_Calculator.xlsm]
2025-10-16 add symbols
    [ESP32.kicad_sch, Encoder.kicad_sch, Ethernet.kicad_sch, GPS.kicad_sch, Power_Management.kicad_sch, RK3588.kicad_sch, TUSB320IRWBR.step, USB4056-03-A_REVA2.step]
2025-10-16 add regulators
    [ESP32.kicad_sch, Encoder.kicad_sch, Ethernet.kicad_sch, GPS.kicad_sch, Power_Management.kicad_sch, RK3588.kicad_sch, TPS22811LRPWR.step, TPS61088RHLR.step]
2025-10-19 add battery management
    [ESP32.kicad_sch, Encoder.kicad_sch, Ethernet.kicad_sch, GPS.kicad_sch, Power_Management.kicad_sch, RK3588.kicad_sch, SN74AHC1G32DCKR.step, TPS55289RYQR.step]
2025-10-28 add ESP32 schematic
    [ESP32.kicad_sch, Encoder.kicad_sch, Ethernet.kicad_sch, GPS.kicad_sch, Power_Management.kicad_sch, RK3588.kicad_sch, WiFi.kicad_sch]
2025-10-28 add GPS schematic
    [GPS.kicad_sch]
2025-10-28 add ethernet schematic
    [Ethernet.kicad_sch]
2025-10-29 add power sequencing
    [ESP32.kicad_sch, Ethernet.kicad_sch, GPS.kicad_sch, Power_Management.kicad_sch, SN74AHC1G32DCKR.step, SN74LVC1G14DBVR.step]
2025-10-29 add WiFi module
    [453-00117_Sona IF573_SCH_Symbol_Altium.SchLib, Power_Management.kicad_sch, Sona IF573_PCB_Footprint.DXF, Sona IF573_PCB_Footprint.PcbDoc, WiFi.kicad_sch]
2025-10-29 add 5V power mux
    [Power_Management.kicad_sch, power_mux_design_calculator.xlsx]
2025-10-29 add battery 3v3 regulator
    [Power_Management.kicad_sch, TPS55289RYQR.step]
2025-10-29 add 0ohm resistors on power management
    [Power_Management.kicad_sch]
2025-10-29 create project for power test board
    [v7_Power_Test_PCB.kicad_pcb, v7_Power_Test_PCB.kicad_sch]
2025-10-30 update fuel gauge
    [453-00117_Sona IF573_SCH_Symbol_Altium.SchLib, SN74LVC1G14DBVR.step, Sona IF573_PCB_Footprint.DXF, Sona IF573_PCB_Footprint.PcbDoc, TPS22811LRPWR.step, TPS61088RHLR.step, TUSB320IRWBR.step, USB4056-03-A_REVA2.step]
2025-10-31 add ESP32
    [v7_Power_Test_PCB.kicad_sch]
2025-10-31 finish schematic and footprint assignments
    [v7_Power_Test_PCB.kicad_sch]
